azonenberg/sata-sniffer/doc/ram-performance.ods

Bank machines | LUT | LUTRAM | FF | Write Mbps | Avail Mbps | Overhead Mbps | Notes
4 | 5212 | 932 | 4469 | 12678 | 9229 | 24554
2 | 4950 | 932 | 4286 | 7413 | 3706 | 32258 | Write BW reduced due to FIFO overflows
8 | 5908 | 932 | 4825 | 11325 | 23248 | 10779
8 |  |  |  | 13025 | 17791 | 15027 | Tweaked arb strategy
 |  |  |  | 11929 | 21044 | 11991 | Tweaked arb strategy
