azonenberg/sata-sniffer/mcu-pmod/mcu-pmod.kicad_pcb

## KiCad design mcu-pmod/mcu-pmod.kicad_pcb (2022-06-13)

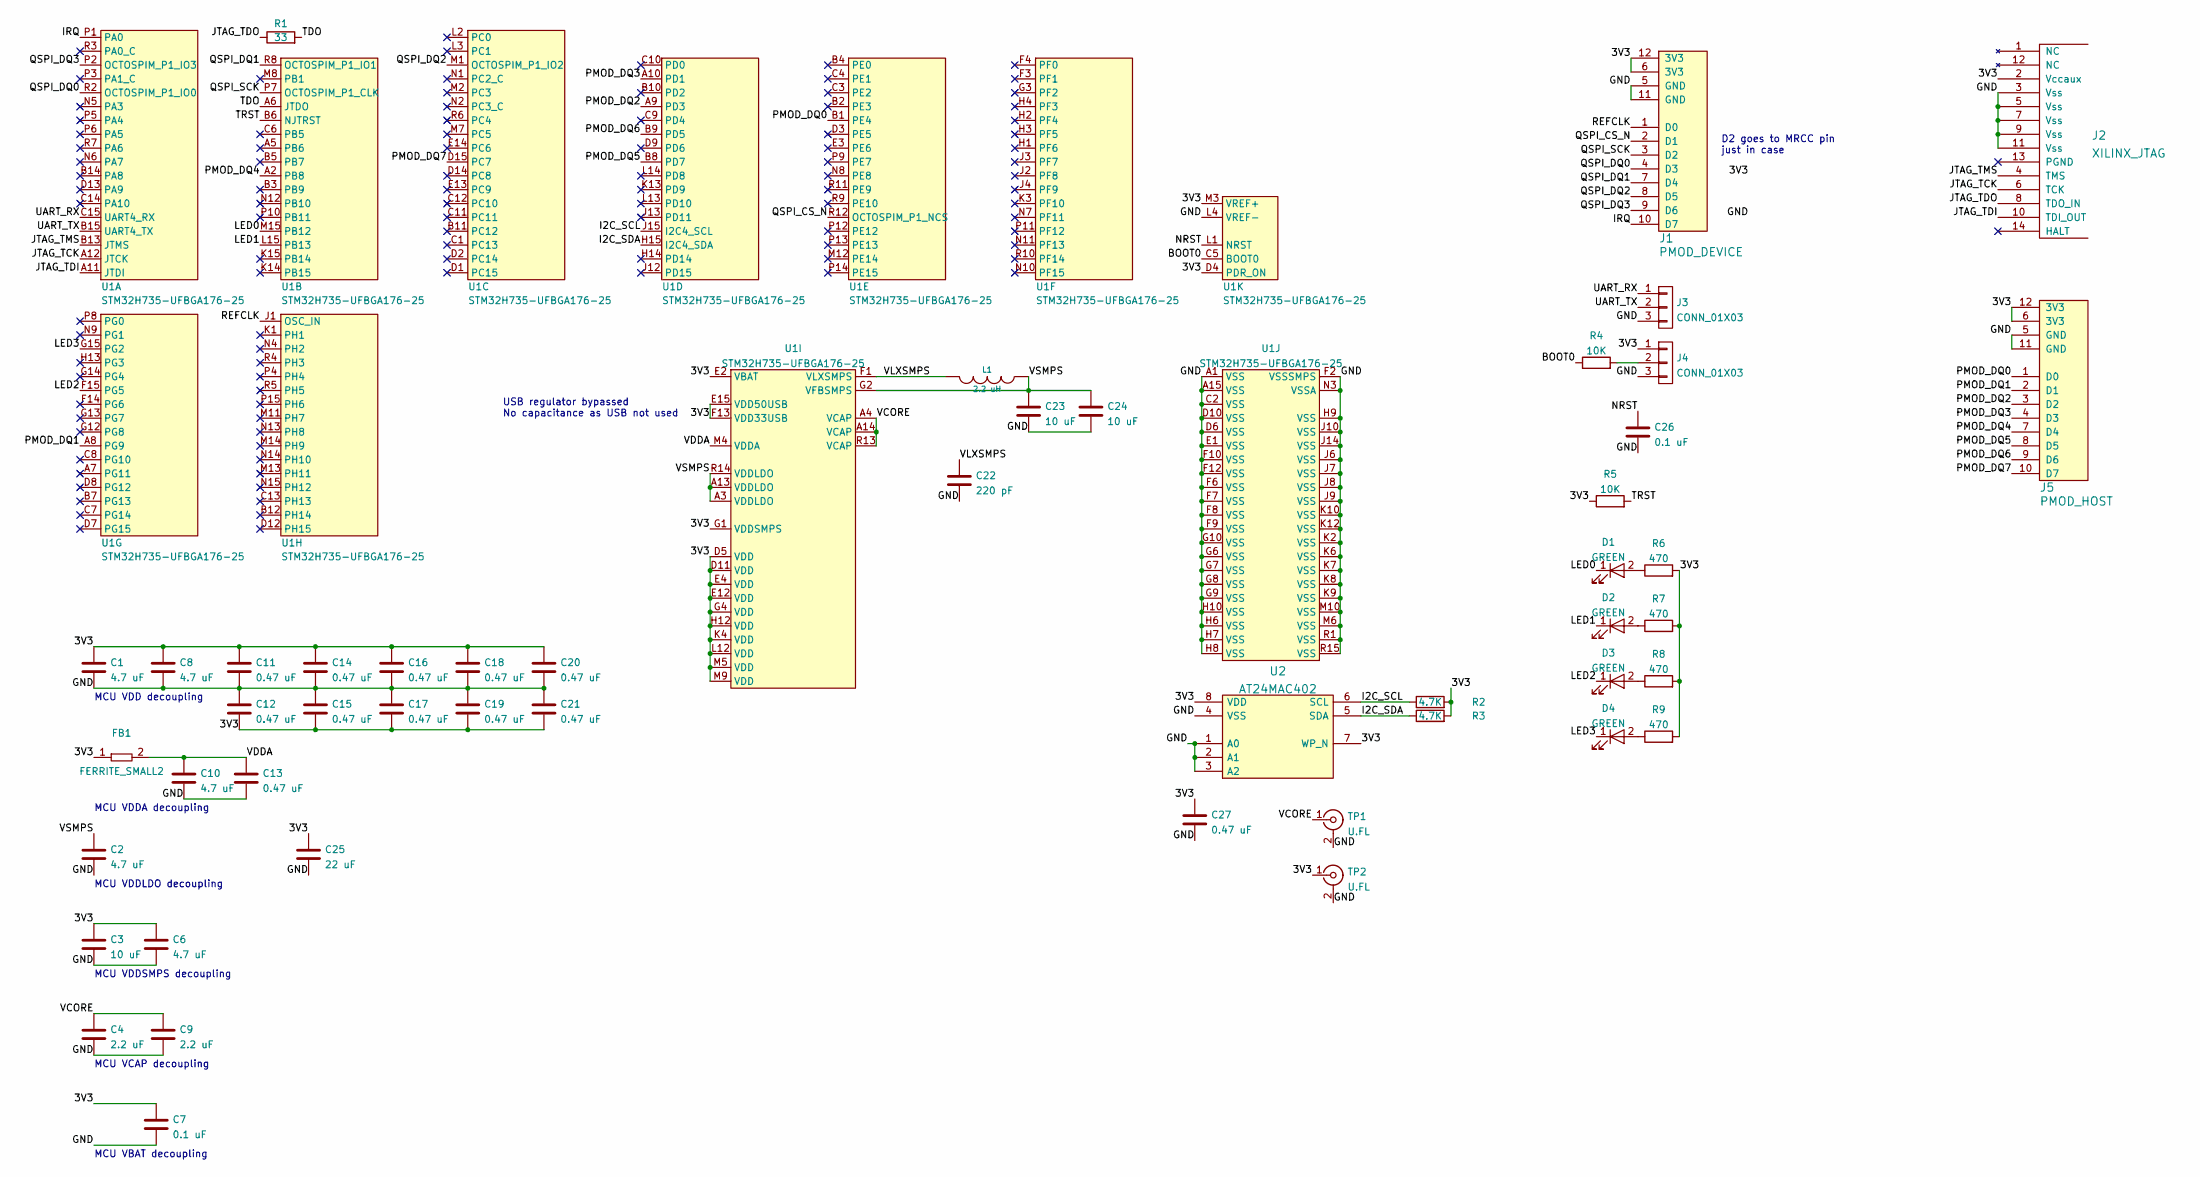
[picture p1: schematic mcu-pmod.kicad_sch, MCU PMOD]

Parts:
C1, C2, C6, C8, C10: 4.7 uF; EIA_0603_CAP_NOSILK
C3, C23, C24: 10 uF; EIA_0805_CAP_NOSILK
C4, C9: 2.2 uF; EIA_0603_CAP_NOSILK
C7, C26: 0.1 uF; EIA_0402_CAP_NOSILK
C11, C12, C13, C14, C15, C16, C17, C18, C19, C20, C21, C27: 0.47 uF; EIA_0402_CAP_NOSILK
C22: 220 pF; EIA_0402_CAP_NOSILK
C25: 22 uF; EIA_1206_CAP_NOSILK
D1, D2, D3, D4: GREEN; EIA_0805_LED
FB1: FERRITE_SMALL2; EIA_0603_INDUCTOR_NOSILK
J1: PMOD_DEVICE; CONN_HEADER_2.54MM_2x6_RA_PMOD_MODULE
J2: XILINX_JTAG; XILINX_JTAG_PTH_MOLEX_0878311420
J3, J4: CONN_01X03; CONN_HEADER_2.54MM_1x3
J5: PMOD_HOST; CONN_HEADER_2.54MM_2x6_RA_PMOD_HOST
L1: 2.2 uH; EIA_1210_CAP_NOSILK
R1: 33; EIA_0402_RES_NOSILK
R2, R3: 4.7K; EIA_0402_RES_NOSILK
R4, R5: 10K; EIA_0402_RES_NOSILK
R6, R7, R8, R9: 470; EIA_0402_RES_NOSILK
TP1, TP2: U.FL; CONN_U.FL_TE_1909763-1
U1: STM32H735-UFBGA176-25; BGA_201_10x10_DEPOP_0.65MM_OSHPARK
U2: AT24MAC402; DFN_8_0.5MM_2x3MM_TALL

Connections:
/3V3: C1.1, C3.1, C6.1, C7.1, C8.1, C11.1, C12.2, C14.1, C15.2, C16.1, C17.2, C18.1, C19.2, C20.1, C21.2, C25.1, C27.1, FB1.1, J1.6 (3V3), J1.12 (3V3), J2.2 (Vccaux), J4.1, J5.6 (3V3), J5.12 (3V3), R2.2, R3.2, R5.1, R6.2, R7.2, R8.2, R9.2, TP2.1 (In), U1.D4 (PDR_ON), U1.D5 (VDD), U1.D11 (VDD), U1.E2 (VBAT), U1.E4 (VDD), U1.E12 (VDD), U1.E15 (VDD50USB), U1.F13 (VDD33USB), U1.G1 (VDDSMPS), U1.G4 (VDD), U1.H12 (VDD), U1.K4 (VDD), U1.L12 (VDD), U1.M3 (VREF+), U1.M5 (VDD), U1.M9 (VDD), U2.7 (WP_N), U2.8 (VDD)
/BOOT0: R4.1, U1.C5 (BOOT0)
/GND: C1.2, C2.2, C3.2, C4.2, C6.2, C7.2, C8.2, C9.2, C10.2, C11.2, C12.1, C13.2, C14.2, C15.1, C16.2, C17.1, C18.2, C19.1, C20.2, C21.1, C22.2, C23.2, C24.2, C25.2, C26.2, C27.2, J1.5 (GND), J1.11 (GND), J2.3 (Vss), J2.5 (Vss), J2.7 (Vss), J2.9 (Vss), J2.11 (Vss), J3.3, J4.3, J5.5 (GND), J5.11 (GND), TP1.2 (Ext), TP2.2 (Ext), U1.A1 (VSS), U1.A15 (VSS), U1.C2 (VSS), U1.D6 (VSS), U1.D10 (VSS), U1.E1 (VSS), U1.F2 (VSSSMPS), U1.F6 (VSS), U1.F7 (VSS), U1.F8 (VSS), U1.F9 (VSS), U1.F10 (VSS), U1.F12 (VSS), U1.G6 (VSS), U1.G7 (VSS), U1.G8 (VSS), U1.G9 (VSS), U1.G10 (VSS), U1.H6 (VSS), U1.H7 (VSS), U1.H8 (VSS), U1.H9 (VSS), U1.H10 (VSS), U1.J6 (VSS), U1.J7 (VSS), U1.J8 (VSS), U1.J9 (VSS), U1.J10 (VSS), U1.J14 (VSS), U1.K2 (VSS), U1.K6 (VSS), U1.K7 (VSS), U1.K8 (VSS), U1.K9 (VSS), U1.K10 (VSS), U1.K12 (VSS), U1.L4 (VREF-), U1.M6 (VSS), U1.M10 (VSS), U1.N3 (VSSA), U1.R1 (VSS), U1.R15 (VSS), U2.1 (A0), U2.2 (A1), U2.3 (A2), U2.4 (VSS)
/I2C_SCL: R2.1, U1.J15 (I2C4_SCL), U2.6 (SCL)
/I2C_SDA: R3.1, U1.H15 (I2C4_SDA), U2.5 (SDA)
/IRQ: J1.10 (D7), U1.P1 (PA0)
/JTAG_TCK: J2.6 (TCK), U1.A12 (JTCK)
/JTAG_TDI: J2.10 (TDI_OUT), U1.A11 (JTDI)
/JTAG_TDO: J2.8 (TDO_IN), R1.1
/JTAG_TMS: J2.4 (TMS), U1.B13 (JTMS)
/LED0: D1.1 (K), U1.M15 (PB12)
/LED1: D2.1 (K), U1.L15 (PB13)
/LED2: D3.1 (K), U1.F15 (PG5)
/LED3: D4.1 (K), U1.G15 (PG2)
/NRST: C26.1, U1.L1 (NRST)
/PMOD_DQ0: J5.1 (D0), U1.B1 (PE4)
/PMOD_DQ1: J5.2 (D1), U1.A8 (PG9)
/PMOD_DQ2: J5.3 (D2), U1.A9 (PD3)
/PMOD_DQ3: J5.4 (D3), U1.A10 (PD1)
/PMOD_DQ4: J5.7 (D4), U1.A2 (PB8)
/PMOD_DQ5: J5.8 (D5), U1.B8 (PD7)
/PMOD_DQ6: J5.9 (D6), U1.B9 (PD5)
/PMOD_DQ7: J5.10 (D7), U1.D15 (PC7)
/QSPI_CS_N: J1.2 (D1), U1.R12 (OCTOSPIM_P1_NCS)
/QSPI_DQ0: J1.4 (D3), U1.R2 (OCTOSPIM_P1_IO0)
/QSPI_DQ1: J1.7 (D4), U1.R8 (OCTOSPIM_P1_IO1)
/QSPI_DQ2: J1.8 (D5), U1.M1 (OCTOSPIM_P1_IO2)
/QSPI_DQ3: J1.9 (D6), U1.P2 (OCTOSPIM_P1_IO3)
/QSPI_SCK: J1.3 (D2), U1.P7 (OCTOSPIM_P1_CLK)
/REFCLK: J1.1 (D0), U1.J1 (OSC_IN)
/TDO: R1.2, U1.A6 (JTDO)
/TRST: R5.2, U1.B6 (NJTRST)
/UART_RX: J3.1, U1.C15 (UART4_RX)
/UART_TX: J3.2, U1.B15 (UART4_TX)
/VCORE: C4.1, C9.1, TP1.1 (In), U1.A4 (VCAP), U1.A14 (VCAP), U1.R13 (VCAP)
/VDDA: C10.1, C13.1, FB1.2, U1.M4 (VDDA)
/VLXSMPS: C22.1, L1.2, U1.F1 (VLXSMPS)
/VSMPS: C2.1, C23.1, C24.1, L1.1, U1.A3 (VDDLDO), U1.A13 (VDDLDO), U1.G2 (VFBSMPS), U1.R14 (VDDLDO)
unnamed: D1.2 (A), R6.1
unnamed: D2.2 (A), R7.1
unnamed: D3.2 (A), R8.1
unnamed: D4.2 (A), R9.1
unnamed: J4.2, R4.2

Notes on the sheet:
MCU VDDA decoupling
D2 goes to MRCC pin just in case
USB regulator bypassed No capacitance as USB not used
MCU VDDSMPS decoupling
MCU VCAP decoupling
MCU VDD decoupling
MCU VDDLDO decoupling
MCU VBAT decoupling

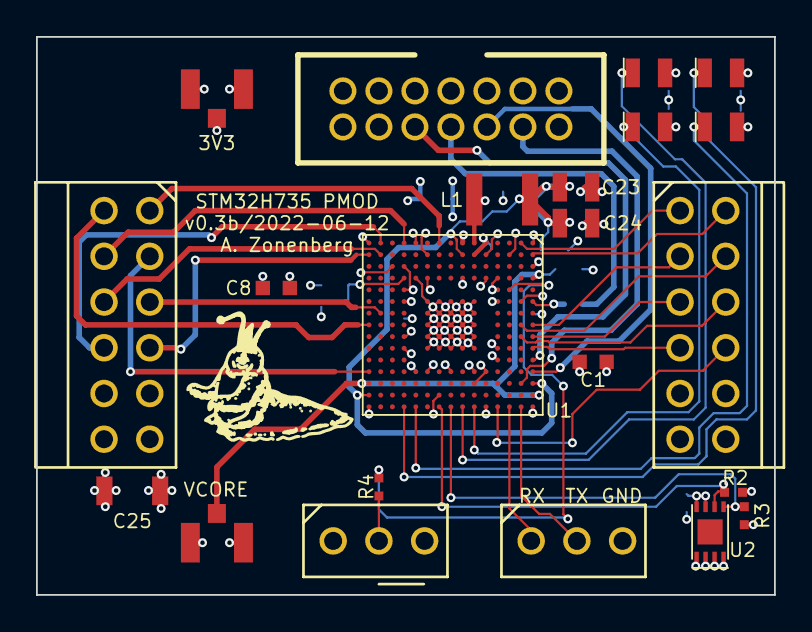
[picture p2: board mcu-pmod.kicad_pcb from above]

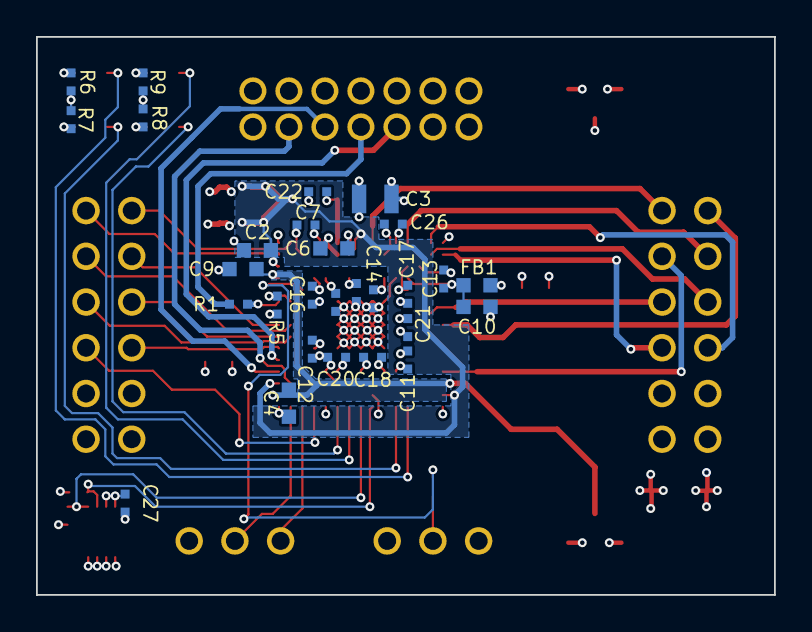
[picture p3: board mcu-pmod.kicad_pcb from below]

Board: 4 copper layers, 41.0 x 31.0 mm, 50 parts (28 on the bottom side), 43 nets.
