azonenberg/sata-sniffer/board/sniffer.kicad_pcb

## KiCad design board/sniffer.kicad_pcb (2021-12-11)

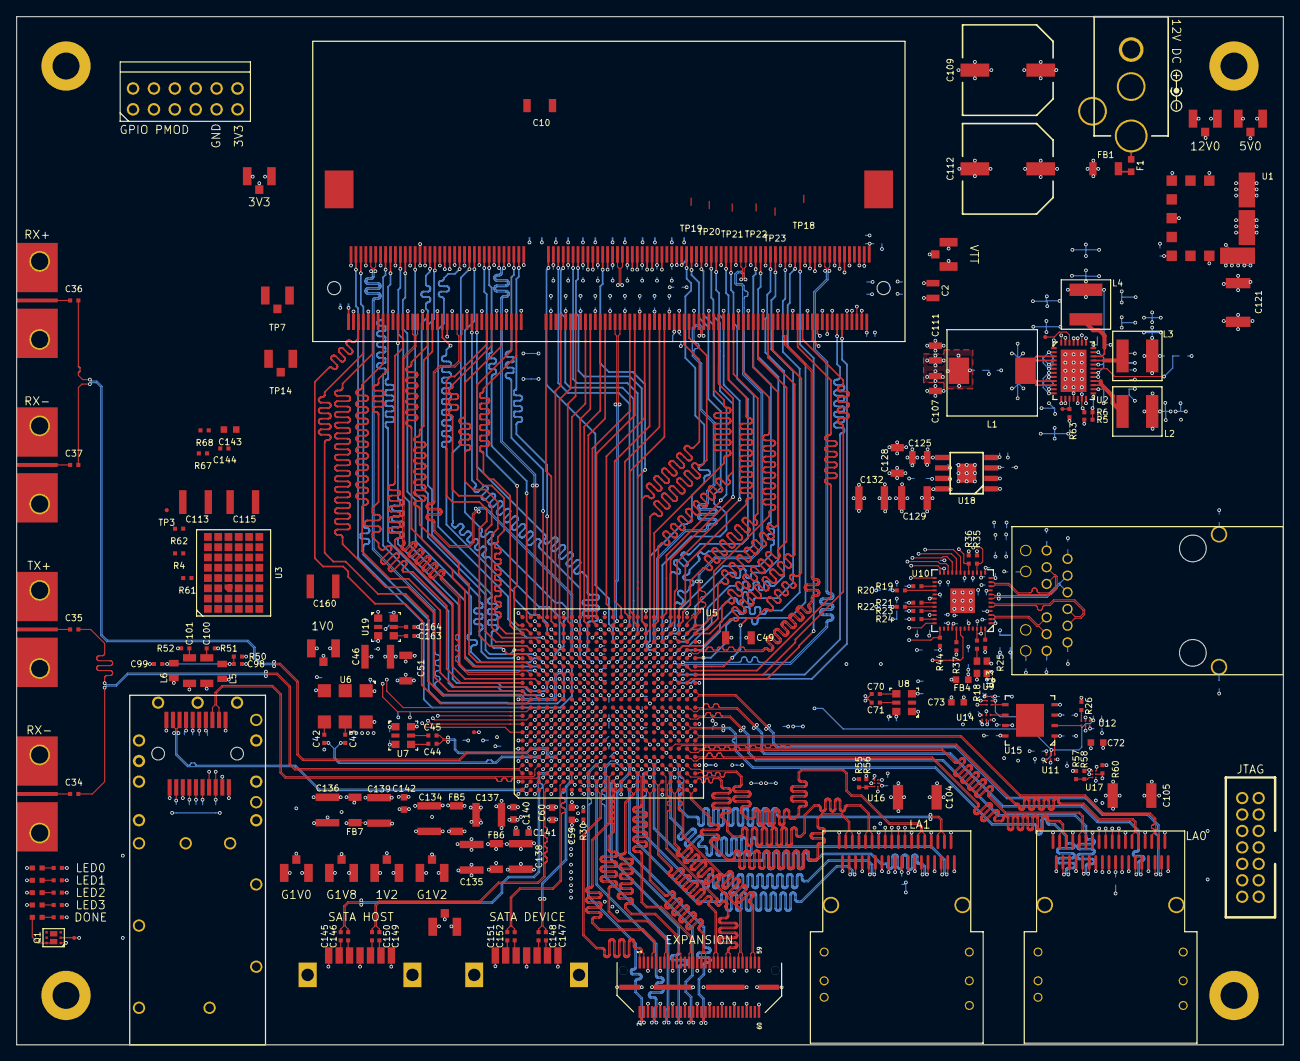
[picture p4: board sniffer.kicad_pcb from above]

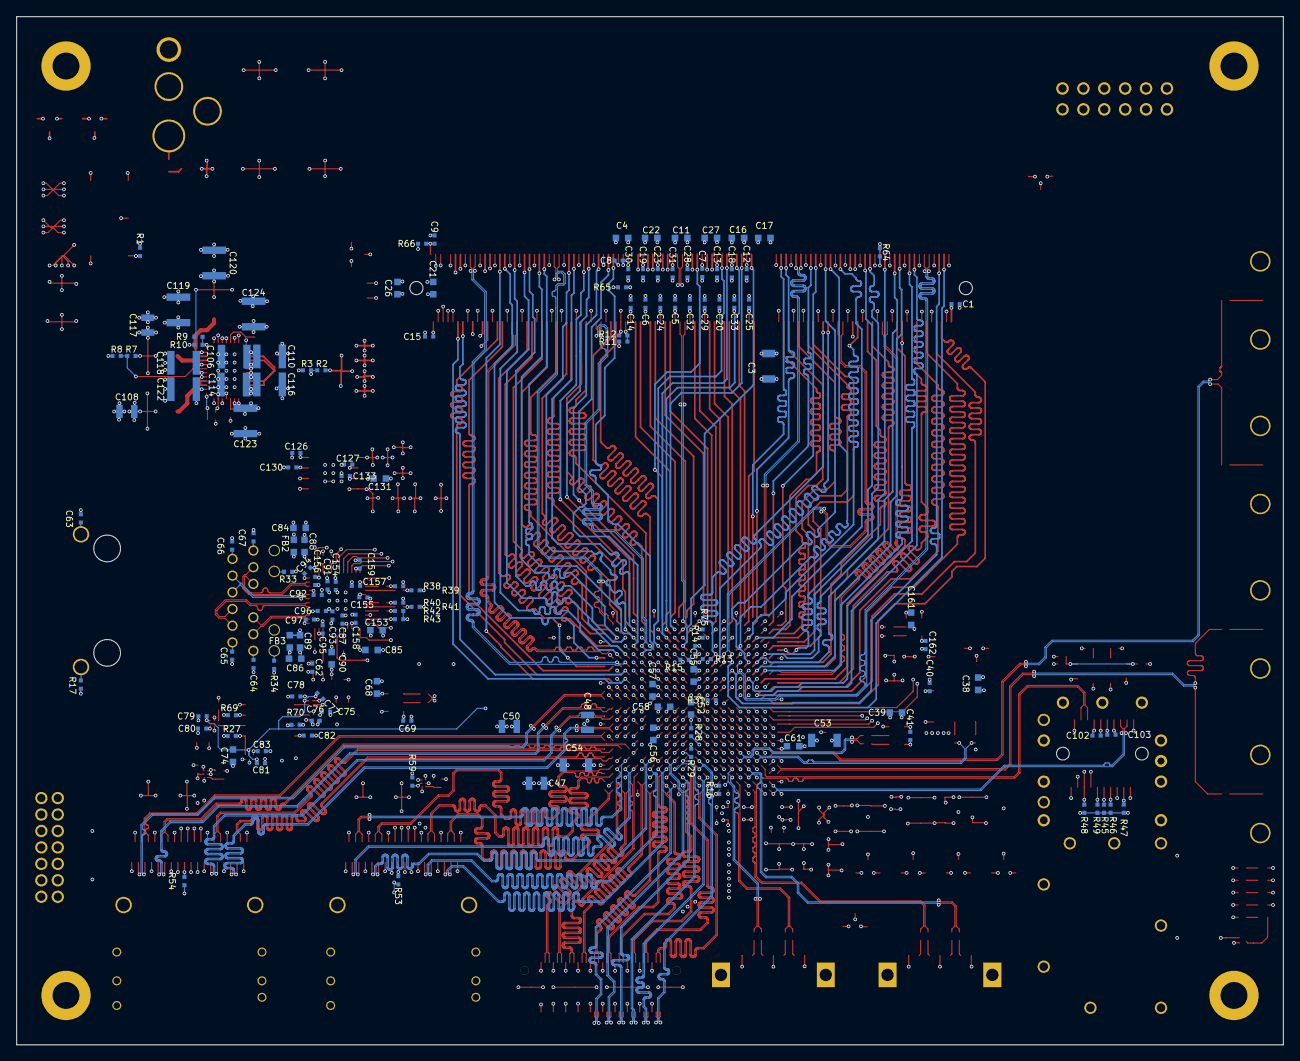
[picture p5: board sniffer.kicad_pcb from below]

Board: 8 copper layers, 154.0 x 125.0 mm, 320 parts (148 on the bottom side), 381 nets.

Parts:
C1, C5, C6, C7, C8, C9, C12, C13, C14, C15, C18, C19, C20, C23, C24, C25, C28, C29, C30, C31, C32, C33, C40, C41, C62, C69, C75, C76, C77, C78, C79, C80, C81, C82, C83, C87, C91, C92, C93, C94, C95, C96, C97, C127, C133, C144, C154, C155, C156, C157, C158, C159, C162: 0.47 uF; EIA_0402_CAP_NOSILK
C2, C117: 22 uF; EIA_0805_CAP_NOSILK
C3, C10, C49, C51, C54: 100 uF; EIA_1206_CAP_NOSILK
C4, C11, C16, C17, C22, C27, C38, C39, C52, C55, C56, C57, C58, C59, C60, C61, C68, C72, C73, C74, C84, C85, C86, C88, C89, C90, C131, C140, C141, C142, C143, C153, C161: 4.7 uF; EIA_0603_CAP_NOSILK
C21, C26: DNP; EIA_0603_CAP_NOSILK
C34, C35, C36, C37, C42, C43, C44, C45, C63, C64, C65, C66, C67, C70, C71, C98, C99, C102, C103, C126, C130, C145, C146, C147, C148, C149, C150, C151, C152, C163, C164: 0.1 uF; EIA_0402_CAP_NOSILK
C46: 330 uF; EIA_1210_CAP_NOSILK
C47, C48, C50, C107, C108, C111, C125: 47 uF; EIA_0805_CAP_NOSILK
C53, C128: 47 uF; EIA_1206_CAP_NOSILK
C100, C101: 22 uF; EIA_1206_CAP_NOSILK
C104, C105: 22 uF 25V; EIA_1812_CAP_NOSILK
C106, C110, C114, C116, C118, C119, C122, C123, C124: 10 uF; EIA_1210_CAP_NOSILK
C109, C112: 470 uF; CAP_AL_10MM_SMT
C113, C115, C129, C132: 100 uF; EIA_1210_CAP_NOSILK
C120: 22 uF; EIA_1210_CAP_NOSILK
C121: 22 uF; EIA_1812_CAP_NOSILK
C134, C135, C136, C137, C138, C139: 47 uF; EIA_1210_CAP_NOSILK
C160: DNP; EIA_1210_CAP_NOSILK
D1, D2, D3, D4, D5: GREEN; EIA_0402_LED
F1: 2A; EIA_0603_CAP_NOSILK
FB1, FB5, FB6, FB7: BLM31KN271SH1L; EIA_1206_CAP_NOSILK
FB2, FB3, FB4: MI0603J601R-10; EIA_0603_INDUCTOR_NOSILK
J1: BARREL; CONN_CUI_PJ-058BH_HIPWR_BARREL_NOSLOT
J2, J5, J6, J7: 32K243-40ML5; CONN_SMA_EDGE_ROSENBERGER_32K243_40ML5
J3: BEL_FUSE_0826-1G1T-23-F; CONN_BELFUSE_0826_1G1T_23_F
J4: XILINX_JTAG; XILINX_JTAG_PTH_MOLEX_0878311420
J8, J9: CONN_SFF8087; CONN_SFF8087_MOLEX_75783-0140
J10: CONN_SFP_HOST; CONN_SFP+_AMPHENOL_UE76_A10_2000T
J11: SFP_CAGE; CONN_SFP_CAGE_TE_2007194-1
J12: PMOD_HOST; CONN_HEADER_2.54MM_2x6_RA_PMOD_HOST
J13: CONN_SATA_DEVICE; CONN_SATA_MOLEX_0674901220
J14: CONN_SATA_HOST; CONN_SATA_MOLEX_0674901220
J15: CONN_LVDS_EXPANSION_HOST; CONN_SAMTEC_QTH-030-01-L-D-A
L1: NS10145T2R2NNA; INDUCTOR_YUDEN_LSRN_10145
L2, L3, L4: NRS5030T2R2NMGJ; INDUCTOR_YUDEN_NRS5030
L5, L6: 4.7 uH; EIA_0805_INDUCTOR_NOSILK
M1, M2, M3, M4: SCREW_HOLE; MECHANICAL_CLEARANCEHOLE_4_40
Q1: SSM6N58NU; DFN_6_0.65MM_2x2MM_GDS
R1: 1.33K; EIA_0402_RES_NOSILK
R2: 442K; EIA_0402_RES_NOSILK
R3, R8: 649K; EIA_0402_RES_NOSILK
R4: 1.78K; EIA_0402_RES_NOSILK
R5: 232K; EIA_0402_RES_NOSILK
R6: 464K; EIA_0402_RES_NOSILK
R7: 806K; EIA_0402_RES_NOSILK
R9: 1.02M; EIA_0402_RES_NOSILK
R10: 324K; EIA_0402_RES_NOSILK
R11, R12: DNP; EIA_0402_RES_NOSILK
R13, R15, R18, R19, R20, R21, R22, R23, R24, R26, R30, R31: 33; EIA_0402_RES_NOSILK
R14, R35, R36, R44, R67, R68: 1K; EIA_0402_RES_NOSILK
R16, R65, R75: 100; EIA_0402_RES_NOSILK
R17, R55, R57: 1M; EIA_0402_RES_NOSILK
R25: 12.1K 1%; EIA_0402_RES_NOSILK
R27, R37, R38, R39, R40, R41, R42, R43, R49, R59, R60, R62, R63, R69, R70: 10K; EIA_0402_RES_NOSILK
R28, R29, R45, R46, R47, R48, R64: 4.7K; EIA_0402_RES_NOSILK
R32, R33, R34, R71, R72, R73, R74: 470; EIA_0402_RES_NOSILK
R50: 0.1; EIA_0402_RES_NOSILK
R51, R52: 0.5; EIA_0402_RES_NOSILK
R53, R54: 100K; EIA_0402_RES_NOSILK
R56, R58: 93.1K; EIA_0402_RES_NOSILK
R61, R66: 0; EIA_0402_RES_NOSILK
TP1, TP2, TP3, TP4, TP5: TESTPOINT; TESTPOINT_SMT_0.5MM
TP6, TP7, TP8, TP9, TP10, TP11, TP12, TP13, TP14, TP15, TP16, TP17: U.FL; CONN_U.FL_TE_1909763-1
TP18, TP19, TP20, TP21, TP22, TP23: TESTTRACE; TESTPOINT_BARETRACE_150UM
U1: OKL-T_3-W12P-C; MODULE_MURATA_OKL-T3-W12
U2: LTC3374-QFN; QFN_38_0.5MM_5x7MM
U3: MYTNA1R84RELA2RA; MODULE_MURATA_MYTNA1R84RELA2RA
U4: DDR3_SODIMM; CONN_SODIMM_DDR3_TE_2013289-1
U5: XC7K70T-2FBG484; BGA_484_22x22_FULLARRAY_1MM
U6: ECX2-LMV-7CN-156.250-TR; OSCILLATOR_LVDS_7.0x5.0
U7, U19: SIT9121AI-2BF-XXS200.000000G; OSCILLATOR_LVDS_3.2x2.5
U8: ECX2-LMV-3CN-125.000-TR; OSCILLATOR_LVDS_3.2x2.5
U9: ECS-2016MVQ-250-CN; OSCILLATOR_2.0x1.6
U10: KSZ9031RN; QFN_48_0.5MM_7x7MM
U11, U12, U13, U14: 74AVCH1T45; DFN_6_0.5MM_1.45x1.00MM
U15: W25Q128JV; DFN_8_1.27MM_6x5MM
U16, U17: FPF2498; BGA_6_1.3x1.0_0.4MM
U18: LP2996A; SOIC_8_3.9MM_EPAD

Connections:
/1V0: C46.1, C51.1, C55.1, C57.1, C113.1, C115.1, C136.1, C160.1, FB7.1, R61.2, TP13.1, U3.G4, U3.G5, U3.H4, U3.H5, U3.H6, U5.J9, U5.J11, U5.J13, U5.J15, U5.K8, U5.K14, U5.L9, U5.L13, U5.L15, U5.M8, U5.M14, U5.N9, U5.N13, U5.N15, U5.P14, U5.R13, U5.R15
/1V2: C86.1, C108.1, C134.1, C153.1, C154.1, C155.1, C156.1, C157.1, C158.1, C159.1, FB3.1, FB4.1, FB5.1, L2.1, R5.1, TP12.1, U10.14, U10.18, U10.23, U10.26, U10.30, U10.39
/1V8: C47.1, C48.1, C50.1, C52.1, C54.1, C56.1, C58.1, C62.1, C73.1, C76.1, C85.1, C87.1, C91.1, C117.1, C135.1, FB6.1, J4.2, L3.1, R7.1, R28.2, R29.2, R37.1, R38.1, R39.1, R40.1, R44.1, TP11.1, U5.AA7, U5.AB4, U5.H7, U5.J7, U5.K10, U5.K12, U5.M4, U5.M10, U5.N1, U5.N7, U5.P7, U5.P8, U5.P10, U5.P12, U5.R5, U5.R9, U5.R11, U5.T2, U5.T12, U5.U9, U5.V6, U5.W3, U5.W13, U5.Y10, U9.1, U9.4, U10.16, U10.34, U10.40, U14.1, U14.5
/1V35: C3.1, C4.1, C5.1, C6.1, C7.1, C10.1, C11.1, C12.1, C13.1, C14.1, C16.1, C17.1, C18.1, C19.1, C20.1, C22.1, C23.1, C24.1, C25.1, C27.1, C28.1, C29.1, C30.1, C31.1, C32.1, C33.1, C49.1, C74.1, C77.1, C79.1, C81.1, C107.1, C111.1, C128.1, C131.1, C133.1, L1.1, R2.1, R11.1, R14.1, R65.2, R67.1, TP14.1, U4.75, U4.76, U4.81, U4.82, U4.87, U4.88, U4.93, U4.94, U4.99, U4.100, U4.105, U4.106, U4.111, U4.112, U4.117, U4.118, U4.123, U4.124, U5.A17, U5.AA17, U5.AB14, U5.B14, U5.C21, U5.D18, U5.E15, U5.F22, U5.G19, U5.H16, U5.K20, U5.L17, U5.N21, U5.P18, U5.T22, U5.U19, U5.V16, U5.Y20, U11.1, U11.5, U12.1, U13.1, U13.5, U18.7
/3.3V I/O/ETH_LED1_P: R33.1, U5.H9
/3.3V I/O/ETH_LED2_P: R34.1, U5.H8
/3.3V I/O/LA0_12V0: C105.1, J9.A11, J9.B8, J9.B9, J9.B10, J9.B11, U17.B1
/3.3V I/O/LA0_12V0_EN: R60.2, U5.F8, U17.B2
/3.3V I/O/LA0_12V0_FAULT: U5.G8, U17.C2
/3.3V I/O/LA0_PRESENCE_DETECT: J9.A10, R54.1, U5.F9
/3.3V I/O/LA0_UART_RX: J9.A8, U5.E9
/3.3V I/O/LA0_UART_TX: J9.A9, U5.E8
/3.3V I/O/LA1_12V0: C104.1, J8.A11, J8.B8, J8.B9, J8.B10, J8.B11, U16.B1
/3.3V I/O/LA1_12V0_EN: R59.2, U5.C9, U16.B2
/3.3V I/O/LA1_12V0_FAULT: U5.D9, U16.C2
/3.3V I/O/LA1_PRESENCE_DETECT: J8.A10, R53.1, U5.C8
/3.3V I/O/LA1_UART_RX: J8.A8, U5.B8
/3.3V I/O/LA1_UART_TX: J8.A9, U5.C10
/3.3V I/O/LED0: R71.2, U5.A8
/3.3V I/O/LED1: R72.2, U5.A9
/3.3V I/O/LED2: R73.2, U5.B10
/3.3V I/O/LED3: R74.2, U5.A10
/3.3V I/O/PMOD_DQ0: J12.1, U5.H10
/3.3V I/O/PMOD_DQ1: J12.2, U5.F10
/3.3V I/O/PMOD_DQ2: J12.3, U5.G11
/3.3V I/O/PMOD_DQ3: J12.4, U5.A11
/3.3V I/O/PMOD_DQ4: J12.7, U5.G10
/3.3V I/O/PMOD_DQ5: J12.8, U5.D10
/3.3V I/O/PMOD_DQ6: J12.9, U5.B11
/3.3V I/O/PMOD_DQ7: J12.10, U5.G12
/3.3V I/O/SFP_MOD_ABS: J10.6, R49.2, U5.E12
/3.3V I/O/SFP_RS0: J10.7, U5.F11
/3.3V I/O/SFP_RS1: J10.9, U5.D11
/3.3V I/O/SFP_RX_LOS: J10.8, R48.2, U5.E11
/3.3V I/O/SFP_TX_DISABLE: J10.3, U5.E13
/3.3V I/O/SFP_TX_FAULT: J10.2, R47.2, U5.F13
/3V3: C38.1, C39.1, C40.1, C41.1, C53.1, C68.1, C69.1, C72.1, C75.1, C78.1, C80.1, C82.1, C83.1, C84.1, C120.1, C127.1, C161.1, C162.1, FB2.1, J12.6, J12.12, L4.1, R9.1, R27.2, R32.1, R45.1, R46.1, R47.1, R48.1, R49.1, R50.2, R53.2, R54.2, R62.2, R63.1, R69.2, R70.1, TP10.1, U4.199, U5.C11, U5.D8, U5.F12, U5.G9, U6.1, U6.6, U7.1, U7.6, U8.1, U8.6, U11.6, U12.6, U13.6, U14.6, U15.8, U18.2, U18.6, U19.1, U19.6
/5V0: C106.1, C110.1, C114.1, C116.1, C118.1, C119.1, C121.1, C122.1, C123.1, C124.1, J15.59, J15.60, TP9.1, U1.4, U1.5, U2.2, U2.5, U2.6, U2.7, U2.8, U2.11, U2.12, U2.17, U2.21, U2.24, U2.25, U2.27, U2.30, U2.32, U2.34, U2.35
/12V0: C109.1, C112.1, FB1.2, R55.1, R57.1, TP8.1, U1.1, U1.2, U1.9, U3.A1, U3.A2, U3.A3, U3.B1, U3.B2, U3.B3, U16.A2, U17.A2
/Boot flash/FLASH_CS: R15.1, U11.3
/Boot flash/FLASH_CS_SHIFT: R27.1, U11.4, U15.1
/Boot flash/FLASH_SCK: R31.2, U14.3
/Boot flash/FLASH_SCK_SHIFT: U14.4, U15.6
/Boot flash/FLASH_SI: R13.1, U13.3
/Boot flash/FLASH_SI_SHIFT: U13.4, U15.5
/Boot flash/FLASH_SO: R26.2, U5.H19
/Boot flash/FLASH_SO_SHIFT: U12.4, U15.2
/DDR/CLK_200_AC_N: C164.1, R75.2, U5.L20
/DDR/CLK_200_AC_P: C163.1, R75.1, U5.L19
/DDR/CLK_200_N: C164.2, U19.5
/DDR/CLK_200_P: C163.2, U19.4
/DDR/RAM_A0: U4.98, U5.M17
/DDR/RAM_A1: U4.97, U5.J22
/DDR/RAM_A2: U4.96, U5.R22
/DDR/RAM_A3: U4.95, U5.J21
/DDR/RAM_A4: U4.92, U5.J20
/DDR/RAM_A5: U4.91, U5.H22
/DDR/RAM_A6: U4.90, U5.H20
/DDR/RAM_A7: U4.86, U5.R18
/DDR/RAM_A8: U4.89, U5.G22
/DDR/RAM_A9: U4.85, U5.G21
/DDR/RAM_A10: U4.107, U5.K21
/DDR/RAM_A11: U4.84, U5.P19
/DDR/RAM_A12: U4.83, U5.F21
/DDR/RAM_A13: U4.119, U5.P22
/DDR/RAM_A14: U4.80, U5.P20
/DDR/RAM_A15: U4.78, U5.P21
/DDR/RAM_BA0: U4.109, U5.K22
/DDR/RAM_BA1: U4.108, U5.N17
/DDR/RAM_BA2: U4.79, U5.E22
/DDR/RAM_CAS_N: U4.115, U5.N22
/DDR/RAM_CK0_N: U4.103, U5.M21
/DDR/RAM_CK0_P: U4.101, U5.N20
/DDR/RAM_CK1_N: U4.104, U5.L21
/DDR/RAM_CK1_P: U4.102, U5.M20
/DDR/RAM_CKE0: U4.73, U5.E21
/DDR/RAM_CKE1: U4.74, U5.M18
/DDR/RAM_CS0_N: U4.114, U5.P16
/DDR/RAM_CS1_N: U4.121, U5.R21
/DDR/RAM_DM0: U4.11, U5.A13
/DDR/RAM_DM1: U4.28, U5.C17
/DDR/RAM_DM2: U4.46, U5.D19
/DDR/RAM_DM3: U4.63, U5.C19
/DDR/RAM_DM4: U4.136, U5.V22
/DDR/RAM_DM5: U4.153, U5.AB21
/DDR/RAM_DM6: U4.170, U5.Y17
/DDR/RAM_DM7: U4.187, U5.Y14
/DDR/RAM_DQ0_0: U4.5, U5.B12
/DDR/RAM_DQ0_1: U4.7, U5.C12
/DDR/RAM_DQ0_2: U4.15, U5.B13
/DDR/RAM_DQ0_3: U4.17, U5.A14
/DDR/RAM_DQ0_4: U4.4, U5.G16
/DDR/RAM_DQ0_5: U4.6, U5.G15
/DDR/RAM_DQ0_6: U4.16, U5.C13
/DDR/RAM_DQ0_7: U4.18, U5.E14
/DDR/RAM_DQ1_0: U4.21, U5.C15
/DDR/RAM_DQ1_1: U4.23, U5.C14
/DDR/RAM_DQ1_2: U4.33, U5.A16
/DDR/RAM_DQ1_3: U4.35, U5.B16
/DDR/RAM_DQ1_4: U4.22, U5.D15
/DDR/RAM_DQ1_5: U4.24, U5.D16
/DDR/RAM_DQ1_6: U4.34, U5.A18
/DDR/RAM_DQ1_7: U4.36, U5.B17
/DDR/RAM_DQ2_0: U4.39, U5.E19
/DDR/RAM_DQ2_1: U4.41, U5.E18
/DDR/RAM_DQ2_2: U4.51, U5.J16
/DDR/RAM_DQ2_3: U4.53, U5.J17
/DDR/RAM_DQ2_4: U4.40, U5.D17
/DDR/RAM_DQ2_5: U4.42, U5.E17
/DDR/RAM_DQ2_6: U4.50, U5.F18
/DDR/RAM_DQ2_7: U4.52, U5.E16
/DDR/RAM_DQ3_0: U4.57, U5.B18
/DDR/RAM_DQ3_1: U4.59, U5.A19
/DDR/RAM_DQ3_2: U4.67, U5.A20
/DDR/RAM_DQ3_3: U4.69, U5.B20
/DDR/RAM_DQ3_4: U4.56, U5.A21
/DDR/RAM_DQ3_5: U4.58, U5.B21
/DDR/RAM_DQ3_6: U4.68, U5.D21
/DDR/RAM_DQ3_7: U4.70, U5.D22
/DDR/RAM_DQ4_0: U4.129, U5.T21
/DDR/RAM_DQ4_1: U4.131, U5.T20
/DDR/RAM_DQ4_2: U4.141, U5.U22
/DDR/RAM_DQ4_3: U4.143, U5.U21
/DDR/RAM_DQ4_4: U4.130, U5.U17
/DDR/RAM_DQ4_5: U4.132, U5.V18
/DDR/RAM_DQ4_6: U4.140, U5.W22
/DDR/RAM_DQ4_7: U4.142, U5.W21
/DDR/RAM_DQ5_0: U4.147, U5.Y22
/DDR/RAM_DQ5_1: U4.149, U5.Y21
/DDR/RAM_DQ5_2: U4.157, U5.AA20
/DDR/RAM_DQ5_3: U4.159, U5.AB20
/DDR/RAM_DQ5_4: U4.146, U5.V20
/DDR/RAM_DQ5_5: U4.148, U5.W20
/DDR/RAM_DQ5_6: U4.158, U5.V19
/DDR/RAM_DQ5_7: U4.160, U5.AA19
/DDR/RAM_DQ6_0: U4.163, U5.Y18
/DDR/RAM_DQ6_1: U4.165, U5.AB16
/DDR/RAM_DQ6_2: U4.175, U5.AA16
/DDR/RAM_DQ6_3: U4.177, U5.AB15
/DDR/RAM_DQ6_4: U4.164, U5.Y19
/DDR/RAM_DQ6_5: U4.166, U5.W17
/DDR/RAM_DQ6_6: U4.174, U5.AB17
/DDR/RAM_DQ6_7: U4.176, U5.AA14
/DDR/RAM_DQ7_0: U4.181, U5.V15
/DDR/RAM_DQ7_1: U4.183, U5.T15
/DDR/RAM_DQ7_2: U4.191, U5.W15
/DDR/RAM_DQ7_3: U4.193, U5.W14
/DDR/RAM_DQ7_4: U4.180, U5.R16
/DDR/RAM_DQ7_5: U4.182, U5.T16
/DDR/RAM_DQ7_6: U4.192, U5.U16
/DDR/RAM_DQ7_7: U4.194, U5.U15
/DDR/RAM_DQS0_N: U4.10, U5.F16
/DDR/RAM_DQS0_P: U4.12, U5.F15
/DDR/RAM_DQS1_N: U4.27, U5.A15
/DDR/RAM_DQS1_P: U4.29, U5.B15
/DDR/RAM_DQS2_N: U4.45, U5.G17
/DDR/RAM_DQS2_P: U4.47, U5.H17
/DDR/RAM_DQS3_N: U4.62, U5.B22
/DDR/RAM_DQS3_P: U4.64, U5.C22
/DDR/RAM_DQS4_N: U4.135, U5.U18
/DDR/RAM_DQS4_P: U4.137, U5.T18
/DDR/RAM_DQS5_N: U4.152, U5.AB22
/DDR/RAM_DQS5_P: U4.154, U5.AA21
/DDR/RAM_DQS6_N: U4.169, U5.AB18
/DDR/RAM_DQS6_P: U4.171, U5.AA18
/DDR/RAM_DQS7_N: U4.186, U5.Y16
/DDR/RAM_DQS7_P: U4.188, U5.W16
/DDR/RAM_ODT0: U4.116, U5.P17
/DDR/RAM_ODT1: U4.120, U5.R17
/DDR/RAM_RAS_N: U4.110, U5.N18
/DDR/RAM_RESET_N: R64.1, U4.30, U5.N19
/DDR/RAM_TEST: R11.2, R12.2, U4.125
/DDR/RAM_WE_N: U4.113, U5.M22
/DDR/TP_VREF: C143.1, C144.1, R67.2, R68.1, TP18.1, TP19.1, TP20.1
/Expansion connector/LA1_DQ0_N: J8.B3, U5.AB1
/Expansion connector/LA1_DQ0_P: J8.B2, U5.AA1
/Expansion connector/LA1_DQ1_N: J8.B6, U5.AA3
/Expansion connector/LA1_DQ1_P: J8.B5, U5.AB2
/Expansion connector/LA1_DQ2_N: J8.B14, U5.AA4
/Expansion connector/LA1_DQ2_P: J8.B13, U5.AB3
/Expansion connector/LA1_DQ3_N: J8.B17, U5.Y4
/Expansion connector/LA1_DQ3_P: J8.B16, U5.W5
/Expansion connector/LA1_DQ4_N: J8.A3, U5.R4
/Expansion connector/LA1_DQ4_P: J8.A2, U5.P4
/Expansion connector/LA1_DQ5_N: J8.A6, U5.U3
/Expansion connector/LA1_DQ5_P: J8.A5, U5.T4
/Expansion connector/LA1_DQ6_N: J8.A14, U5.U5
/Expansion connector/LA1_DQ6_P: J8.A13, U5.T5
/Expansion connector/LA1_DQ7_N: J8.A17, U5.W4
/Expansion connector/LA1_DQ7_P: J8.A16, U5.V4
/Expansion connector/LVDS0_N: J15.3, U5.L1
/Expansion connector/LVDS0_P: J15.1, U5.K1
/Expansion connector/LVDS1_N: J15.9, U5.M3
/Expansion connector/LVDS1_P: J15.7, U5.L3
/Expansion connector/LVDS2_N: J15.15, U5.M2
/Expansion connector/LVDS2_P: J15.13, U5.M1
/Expansion connector/LVDS3_N: J15.21, U5.R1
/Expansion connector/LVDS3_P: J15.19, U5.P1
/Expansion connector/LVDS4_N: J15.27, U5.T3
/Expansion connector/LVDS4_P: J15.25, U5.R3
/Expansion connector/LVDS5_N: J15.33, U5.U1
/Expansion connector/LVDS5_P: J15.31, U5.T1
/Expansion connector/LVDS6_N: J15.39, U5.V2
/Expansion connector/LVDS6_P: J15.37, U5.U2
/Expansion connector/LVDS7_N: J15.45, U5.W2
/Expansion connector/LVDS7_P: J15.43, U5.V3
/Expansion connector/LVDS8_N: J15.51, U5.Y1
/Expansion connector/LVDS8_P: J15.49, U5.W1
/Expansion connector/LVDS9_N: J15.57, U5.Y3
/Expansion connector/LVDS9_P: J15.55, U5.Y2
/Expansion connector/LVDS10_N: J15.4, U5.L4
/Expansion connector/LVDS10_P: J15.2, U5.L5
/Expansion connector/LVDS11_N: J15.10, U5.K2
/Expansion connector/LVDS11_P: J15.8, U5.K3
/Expansion connector/LVDS12_N: J15.16, U5.N4
/Expansion connector/LVDS12_P: J15.14, U5.M5
/Expansion connector/LVDS13_N: J15.22, U5.N2
/Expansion connector/LVDS13_P: J15.20, U5.N3
/Expansion connector/LVDS14_N: J15.28, U5.P5
/Expansion connector/LVDS14_P: J15.26, U5.N5
/Expansion connector/LVDS15_N: J15.34, U5.R2
/Expansion connector/LVDS15_P: J15.32, U5.P2
/FPGA power/GTX_1V0: C61.1, C139.1, C142.1, FB7.2, TP17.1, U5.A6, U5.C6, U5.E6, U5.G6
/FPGA power/GTX_1V8: C59.1, C138.1, C141.1, FB6.2, TP16.1, U5.J4
/FPGA support/FPGA_DONE: Q1.G1, TP1.1, U5.P6
/FPGA support/FPGA_INIT_B: R28.1, TP2.1, U5.L7
/FPGA support/FPGA_RST_N: R29.1, U5.M6
/FPGA support/JTAG_TCK: J4.6, U5.K7
/FPGA support/JTAG_TDI: J4.10, U5.K6
/FPGA support/JTAG_TDO: J4.8, R30.2
/FPGA support/JTAG_TMS: J4.4, U5.L6
/GND: C1.2, C2.2, C3.2, C4.2, C5.2, C6.2, C7.2, C8.2, C9.2, C10.2, C11.2, C12.2, C13.2, C14.2, C15.2, C16.2, C17.2, C18.2, C19.2, C20.2, C21.2, C22.2, C23.2, C24.2, C25.2, C26.2, C27.2, C28.2, C29.2, C30.2, C31.2, C32.2, C33.2, C38.2, C39.2, C40.2, C41.2, C46.2, C47.2, C48.2, C49.2, C50.2, C51.2, C52.2, C53.2, C54.2, C55.2, C56.2, C57.2, C58.2, C59.2, C60.2, C61.2, C62.2, C63.1, C64.1, C65.1, C66.1, C67.1, C68.2, C69.2, C72.2, C73.2, C74.2, C75.2, C76.2, C77.2, C78.2, C79.2, C80.2, C81.2, C82.2, C83.2, C84.2, C85.2, C86.2, C87.2, C88.2, C89.2, C90.2, C91.2, C92.2, C93.2, C94.2, C95.2, C96.2, C97.2, C98.2, C99.2, C102.2, C103.2, C104.2, C105.2, C106.2, C107.2, C108.2, C109.2, C110.2, C111.2, C112.2, C113.2, C114.2, C115.2, C116.2, C117.2, C118.2, C119.2, C120.2, C121.2, C122.2, C123.2, C124.2, C125.2, C126.2, C127.2, C128.2, C129.2, C130.2, C131.2, C132.2, C133.2, C134.2, C135.2, C136.2, C137.2, C138.2, C139.2, C140.2, C141.2, C142.2, C143.2, C144.2, C153.2, C154.2, C155.2, C156.2, C157.2, C158.2, C159.2, C160.2, C161.2, C162.2, D2.1, D3.1, D4.1, D5.1, J1.2, J2.2, J3.13, J3.15, J4.3, J4.5, J4.7, J4.9, J4.11, J5.2, J6.2, J7.2, J8.A1, J8.A4, J8.A7, J8.A12, J8.A15, J8.A18, J8.B1, J8.B4, J8.B7, J8.B12, J8.B15, J8.B18, J8.SHLD, J9.A1, J9.A4, J9.A7, J9.A12, J9.A15, J9.A18, J9.B1, J9.B4, J9.B7, J9.B12, J9.B15, J9.B18, J9.SHLD, J10.1, J10.10, J10.11, J10.14, J10.17, J10.20, J11.1, J12.5, J12.11, J13.1, J13.4, J13.7, J14.1, J14.4, J14.7, J15.5, J15.6, J15.11, J15.12, J15.17, J15.18, J15.23, J15.24, J15.29, J15.30, J15.35, J15.36, J15.41, J15.42, J15.47, J15.48, J15.53, J15.54, J15.GND, Q1.S1, R1.1, R3.2, R6.2, R8.2, R10.2, R12.1, R17.1, R25.1, R35.1, R36.1, R41.1, R42.1, R43.1, R51.1, R52.1, R56.2, R58.2, R59.1, R60.1, R64.2, R68.2, TP6.2, TP7.2, TP8.2, TP9.2, TP10.2, TP11.2, TP12.2, TP13.2, TP14.2, TP15.2, TP16.2, TP17.2, TP21.1, TP22.1, TP23.1, U1.3, U1.7, U2.13, U2.14, U2.16, U2.18, U2.37, U2.PAD, U3.A4, U3.A5, U3.A6, U3.B4, U3.B5, U3.B6, U3.C2, U3.C3, U3.C4, U3.C5, U3.D2, U3.D3, U3.D4, U3.D5, U3.E2, U3.E3, U3.E4, U3.E5, U3.F2, U3.F3, U3.F4, U3.F5, U3.G1, U3.G2, U3.G3, U3.H1, U3.H2, U3.H3, U4.2, U4.3, U4.8, U4.9, U4.13, U4.14, U4.19, U4.20, U4.25, U4.26, U4.31, U4.32, U4.37, U4.38, U4.43, U4.44, U4.48, U4.49, U4.54, U4.55, U4.60, U4.61, U4.65, U4.66, U4.71, U4.72, U4.127, U4.128, U4.133, U4.134, U4.138, U4.139, U4.144, U4.145, U4.150, U4.151, U4.155, U4.156, U4.161, U4.162, U4.167, U4.168, U4.172, U4.173, U4.178, U4.179, U4.184, U4.185, U4.189, U4.190, U4.195, U4.196, U4.197, U4.201, U5.A1, U5.A5, U5.A7, U5.A12, U5.A22, U5.AA2, U5.AA12, U5.AA22, U5.AB9, U5.AB19, U5.B3, U5.B4, U5.B7, U5.B9, U5.B19, U5.C1, U5.C5, U5.C7, U5.C16, U5.D3, U5.D4, U5.D7, U5.D13, U5.E1, U5.E5, U5.E7, U5.E10, U5.E20, U5.F3, U5.F4, U5.F7, U5.F17, U5.G1, U5.G5, U5.G14, U5.H3, U5.H4, U5.H5, U5.H6, U5.H11, U5.H21, U5.J1, U5.J2, U5.J3, U5.J5, U5.J8, U5.J10, U5.J12, U5.J14, U5.J18, U5.K5, U5.K9, U5.K11, U5.K13, U5.K15, U5.L2, U5.L8, U5.L10, U5.L11, U5.L12, U5.L14, U5.L22, U5.M7, U5.M9, U5.M11, U5.M12, U5.M13, U5.M15, U5.M19, U5.N6, U5.N8, U5.N10, U5.N11, U5.N12, U5.N14, U5.N16, U5.P3, U5.P9, U5.P11, U5.P13, U5.P15, U5.R8, U5.R10, U5.R12, U5.R14, U5.R20, U5.T7, U5.T17, U5.U4, U5.U14, U5.V1, U5.V11, U5.V21, U5.W8, U5.W18, U5.Y5, U5.Y15, U6.3, U7.3, U8.3, U9.2, U10.13, U10.29, U10.PAD, U11.2, U12.2, U12.5, U13.2, U14.2, U15.4, U16.A1, U17.A1, U18.1, U18.PAD, U19.3
/GTX_1V2: C60.1, C137.1, C140.1, FB5.2, R16.1, TP15.1, U5.A2, U5.C2, U5.E2, U5.G2, U5.H1
/Power Supply/1V0_GOOD: R62.1, TP3.1, U2.19, U2.33, U2.38, U3.C1
/Power Supply/1V0_SENSE: R61.1, U3.F1
/Power Supply/1V2_FB: R5.2, R6.1, U2.20
/Power Supply/1V2_SW: L2.2, U2.22, U2.23
/Power Supply/1V8_FB: R7.2, R8.1, U2.26
/Power Supply/1V35_FB: R2.2, R3.1, U2.1
/Power Supply/1V35_SW: L1.2, U2.3, U2.4, U2.9, U2.10
/Power Supply/3V3_FB: R9.2, R10.1, U2.31
/Power Supply/12V0_FUSED: F1.2, FB1.1
/Power Supply/12V0_RAW: F1.1, J1.1
/Power Supply/LTC_PGOOD: R63.2, TP5.1, U2.15
/Power Supply/PSU_TEMP: TP4.1, U2.36
/Power Supply/VDDQ_SENSE: C125.1, R65.1, U18.5
/Power Supply/VTT_SENSE: C130.1, R66.2, U18.3
/RAM_SCL: U4.202, U5.H14
/RAM_SDA: U4.200, U5.F14
/RAM_VREF: C1.1, C8.1, C126.1, TP7.1, U4.1, U4.126, U5.C20, U5.D14, U5.K17, U5.R19, U5.U20, U5.V17, U18.4
/RAM_VTT: C2.1, C9.1, C15.1, C21.1, C26.1, C129.1, C132.1, R66.1, TP6.1, U4.203, U4.204, U18.8
/RGMII PHY/A1V2: C89.1, C92.1, C96.1, FB3.2, U10.4, U10.9
/RGMII PHY/A1V2_PLL: C90.1, C93.1, FB4.2, U10.44
/RGMII PHY/A3V3: C88.1, C94.1, C95.1, C97.1, FB2.2, U10.1, U10.12, U10.47
/RGMII PHY/CLK_125_AC_N: C71.1, U5.U10
/RGMII PHY/CLK_125_AC_P: C70.1, U5.V9
/RGMII PHY/CLK_125_N: C71.2, U8.5
/RGMII PHY/CLK_125_P: C70.2, U8.4
/RGMII PHY/ETH_A_N: J3.10, U10.3
/RGMII PHY/ETH_A_P: J3.11, U10.2
/RGMII PHY/ETH_B_N: J3.5, U10.6
/RGMII PHY/ETH_B_P: J3.4, U10.5
/RGMII PHY/ETH_CLK_25MHZ: R18.1, U10.46
/RGMII PHY/ETH_C_N: J3.2, U10.8
/RGMII PHY/ETH_C_P: J3.3, U10.7
/RGMII PHY/ETH_D_N: J3.9, U10.11
/RGMII PHY/ETH_D_P: J3.8, U10.10
/RGMII PHY/ETH_LED1_N_1V8: R36.2, U5.U12, U10.17
/RGMII PHY/ETH_LED2_N_1V8: R35.2, U5.U13, U10.15
/RGMII PHY/ETH_MDC: U5.V8, U10.36
/RGMII PHY/ETH_MDIO: R44.2, U5.Y8, U10.37
/RGMII PHY/ETH_RST_N: U5.V7, U10.42
/RGMII PHY/ETH_RXD0: R22.1, R41.2, U5.W11
/RGMII PHY/ETH_RXD1: R21.1, R40.2, U5.W10
/RGMII PHY/ETH_RXD2: R20.1, R39.2, U5.Y11
/RGMII PHY/ETH_RXD3: R19.1, R38.2, U5.U11
/RGMII PHY/ETH_RX_CLK: R24.1, R43.2, U5.W9
/RGMII PHY/ETH_RX_DV: R23.1, R42.2, U5.Y9
/RGMII PHY/LA0_DQ0_N: J9.B3, U5.AB5
/RGMII PHY/LA0_DQ0_P: J9.B2, U5.AA5
/RGMII PHY/LA0_DQ1_N: J9.B6, U5.AB6
/RGMII PHY/LA0_DQ1_P: J9.B5, U5.AA6
/RGMII PHY/LA0_DQ2_N: J9.B14, U5.W6
/RGMII PHY/LA0_DQ2_P: J9.B13, U5.Y6
/RGMII PHY/LA0_DQ3_N: J9.B17, U5.AB8
/RGMII PHY/LA0_DQ3_P: J9.B16, U5.AB7
/RGMII PHY/LA0_DQ4_N: J9.A3, U5.AA9
/RGMII PHY/LA0_DQ4_P: J9.A2, U5.AA8
/RGMII PHY/LA0_DQ5_N: J9.A6, U5.AB10
/RGMII PHY/LA0_DQ5_P: J9.A5, U5.AA10
/RGMII PHY/LA0_DQ6_N: J9.A14, U5.AB11
/RGMII PHY/LA0_DQ6_P: J9.A13, U5.AA11
/RGMII PHY/LA0_DQ7_N: J9.A17, U5.AB13
/RGMII PHY/LA0_DQ7_P: J9.A16, U5.AB12
/RGMII PHY/RGMII_TXD0: U5.AA13, U10.19
/RGMII PHY/RGMII_TXD1: U5.Y13, U10.20
/RGMII PHY/RGMII_TXD2: U5.V13, U10.21
/RGMII PHY/RGMII_TXD3: U5.Y12, U10.22
/RGMII PHY/RGMII_TX_CLK: U5.W12, U10.24
/RGMII PHY/RGMII_TX_EN: U5.V12, U10.25
/SERDES interfaces/GTX_RX1_N: C148.1, U5.G3
/SERDES interfaces/GTX_RX1_P: C147.1, U5.G4
/SERDES interfaces/GTX_RX2_N: C146.1, U5.E3
/SERDES interfaces/GTX_RX2_P: C145.1, U5.E4
/SERDES interfaces/GTX_RX3_AC_N: C37.2, J5.1
/SERDES interfaces/GTX_RX3_AC_P: C36.2, J2.1
/SERDES interfaces/GTX_RX3_N: C37.1, U5.B5
/SERDES interfaces/GTX_RX3_P: C36.1, U5.B6
/SERDES interfaces/GTX_TX1_N: C152.1, U5.F1
/SERDES interfaces/GTX_TX1_P: C151.1, U5.F2
/SERDES interfaces/GTX_TX2_N: C150.1, U5.D2
/SERDES interfaces/GTX_TX2_P: C149.1, U5.D1
/SERDES interfaces/GTX_TX3_AC_N: C34.2, J6.1
/SERDES interfaces/GTX_TX3_AC_P: C35.2, J7.1
/SERDES interfaces/GTX_TX3_N: C34.1, U5.A3
/SERDES interfaces/GTX_TX3_P: C35.1, U5.A4
/SERDES interfaces/REFCLK_156_AC_N: C43.1, U5.D6
/SERDES interfaces/REFCLK_156_AC_P: C42.1, U5.D5
/SERDES interfaces/REFCLK_156_N: C43.2, U6.5
/SERDES interfaces/REFCLK_156_P: C42.2, U6.4
/SERDES interfaces/REFCLK_200_AC_N: C45.1, U5.F6
/SERDES interfaces/REFCLK_200_AC_P: C44.1, U5.F5
/SERDES interfaces/REFCLK_200_N: C45.2, U7.5
/SERDES interfaces/REFCLK_200_P: C44.2, U7.4
/SERDES interfaces/SATA_DEV_RX_N: C148.2, J13.3
/SERDES interfaces/SATA_DEV_RX_P: C147.2, J13.2
/SERDES interfaces/SATA_DEV_TX_N: C152.2, J13.5
/SERDES interfaces/SATA_DEV_TX_P: C151.2, J13.6
/SERDES interfaces/SATA_HOST_RX_N: C146.2, J14.5
/SERDES interfaces/SATA_HOST_RX_P: C145.2, J14.6
/SERDES interfaces/SATA_HOST_TX_N: C150.2, J14.3
/SERDES interfaces/SATA_HOST_TX_P: C149.2, J14.2
/SERDES interfaces/SFP_I2C_SCL: J10.5, R45.2, U5.H13
/SERDES interfaces/SFP_I2C_SDA: J10.4, R46.2, U5.G13
/SERDES interfaces/SFP_RX_N: J10.12, U5.C3
/SERDES interfaces/SFP_RX_P: J10.13, U5.C4
/SERDES interfaces/SFP_TX_N: J10.19, U5.B1
/SERDES interfaces/SFP_TX_P: J10.18, U5.B2
/SERDES interfaces/SFP_VDD_RX: C100.1, C102.1, J10.15, L5.1
/SERDES interfaces/SFP_VDD_TX: C101.1, C103.1, J10.16, L6.1
unnamed: C63.2, J3.17, R17.2
unnamed: C64.2, J3.12
unnamed: C65.2, J3.6
unnamed: C66.2, J3.1
unnamed: C67.2, J3.7
unnamed: C98.1, C99.1, L5.2, L6.2, R50.1
unnamed: C100.2, R51.2
unnamed: C101.2, R52.2
unnamed: D1.1, Q1.D1
unnamed: D1.2, R32.2
unnamed: D2.2, R71.1
unnamed: D3.2, R72.1
unnamed: D4.2, R73.1
unnamed: D5.2, R74.1
unnamed: J3.14, R33.2
unnamed: J3.16, R34.2
unnamed: L3.2, U2.28
unnamed: L4.2, U2.29
unnamed: R1.2, U1.6
unnamed: R4.1, U3.E1
unnamed: R4.2, U3.D1
unnamed: R13.2, U5.H18
unnamed: R14.2, U5.K18
unnamed: R15.2, U5.L16
unnamed: R16.2, U5.H2
unnamed: R18.2, U9.3
unnamed: R19.2, U10.27
unnamed: R20.2, U10.28
unnamed: R21.2, U10.31
unnamed: R22.2, U10.32
unnamed: R23.2, U10.33
unnamed: R24.2, U10.35
unnamed: R25.2, U10.48
unnamed: R26.1, U12.3
unnamed: R30.1, U5.J6
unnamed: R31.1, U5.G7
unnamed: R37.2, U10.41
unnamed: R55.2, R56.1, U16.C1
unnamed: R57.2, R58.1, U17.C1
unnamed: R69.1, U15.3
unnamed: R70.2, U15.7
