azonenberg/sata-sniffer/rtl/vivado-project/sniffer.srcs/constrs_1/new/top.xdc

set_max_delay -datapath_only -from [get_clocks clk_ram_2x_raw] -through [get_nets [list {ethernet/baser_rx_cdc/rx_cdc_fifo/sync_head/reg_a_ff_reg_n_0_[0]} \
          {ethernet/baser_rx_cdc/rx_cdc_fifo/sync_head/reg_a_ff_reg_n_0_[10]} \
          {ethernet/baser_rx_cdc/rx_cdc_fifo/sync_head/reg_a_ff_reg_n_0_[1]} \
          {ethernet/baser_rx_cdc/rx_cdc_fifo/sync_head/reg_a_ff_reg_n_0_[2]} \
          {ethernet/baser_rx_cdc/rx_cdc_fifo/sync_head/reg_a_ff_reg_n_0_[3]} \
          {ethernet/baser_rx_cdc/rx_cdc_fifo/sync_head/reg_a_ff_reg_n_0_[4]} \
          {ethernet/baser_rx_cdc/rx_cdc_fifo/sync_head/reg_a_ff_reg_n_0_[5]} \
          {ethernet/baser_rx_cdc/rx_cdc_fifo/sync_head/reg_a_ff_reg_n_0_[6]} \
          {ethernet/baser_rx_cdc/rx_cdc_fifo/sync_head/reg_a_ff_reg_n_0_[7]} \
          {ethernet/baser_rx_cdc/rx_cdc_fifo/sync_head/reg_a_ff_reg_n_0_[8]} \
          {ethernet/baser_rx_cdc/rx_cdc_fifo/sync_head/reg_a_ff_reg_n_0_[9]} \
          ethernet/baser_rx_cdc/rx_cdc_fifo/sync_head/sync_ack/sync/dout0 \
          ethernet/baser_rx_cdc/rx_cdc_fifo/sync_head/sync_ack/sync/dout0_reg_0 \
          ethernet/baser_rx_cdc/rx_cdc_fifo/sync_head/sync_en/sync/dout0 \
          ethernet/baser_rx_cdc/rx_cdc_fifo/sync_head/sync_en/sync/dout0_reg_0 \
          {ethernet/baser_rx_cdc/rx_cdc_fifo/sync_tail/reg_a_ff__0[0]} \
          {ethernet/baser_rx_cdc/rx_cdc_fifo/sync_tail/reg_a_ff__0[10]} \
          {ethernet/baser_rx_cdc/rx_cdc_fifo/sync_tail/reg_a_ff__0[1]} \
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
          ethernet/cdc/sync_our_mac_addr_baser_txclk/sync_ack/sync/dout0 \
          ethernet/cdc/sync_our_mac_addr_baser_txclk/sync_ack/sync/dout0_reg_0 \
          ethernet/cdc/sync_our_mac_addr_baser_txclk/sync_en/sync/dout0 \
          ethernet/cdc/sync_our_mac_addr_baser_txclk/sync_en/sync/dout0_reg_0 \
          ethernet/cdc/sync_our_mac_addr_baset_txclk/sync_ack/sync/dout0 \
          ethernet/cdc/sync_our_mac_addr_baset_txclk/sync_ack/sync/dout0_reg_0 \
          ethernet/cdc/sync_our_mac_addr_baset_txclk/sync_en/sync/dout0 \
          ethernet/cdc/sync_our_mac_addr_baset_txclk/sync_en/sync/dout0_reg_0 \
          ethernet/cdc/sync_our_mac_addr_clk_ipstack/sync_ack/sync/dout0 \
          ethernet/cdc/sync_our_mac_addr_clk_ipstack/sync_ack/sync/dout0_reg_0 \
          ethernet/cdc/sync_our_mac_addr_clk_ipstack/sync_en/sync/dout0 \
          ethernet/cdc/sync_our_mac_addr_clk_ipstack/sync_en/sync/dout0_reg_0 \
          ethernet/rgmii/gig_mac_wrapper/mac/dout0_reg \
          ethernet/rgmii/gig_mac_wrapper/mac/sync_link_speed/dout0_reg \
          ethernet/rgmii/gig_mac_wrapper/mac/sync_link_speed/sync_ack/sync/dout0 \
          ethernet/rgmii/gig_mac_wrapper/mac/sync_link_speed/sync_ack/sync/dout0_reg_0 \
          ethernet/rgmii/gig_mac_wrapper/mac/sync_link_speed/sync_en/dout0_reg \
          ethernet/rgmii/gig_mac_wrapper/mac/sync_link_speed/sync_en/sync/dout0 \
          ethernet/rgmii/gig_mac_wrapper/mac/sync_link_speed/sync_en/sync/dout0_reg_0 \
          ethernet/rgmii/gig_mac_wrapper/mac/sync_link_speed/sync_en/sync/dout0_reg_1 \
          {ethernet/rgmii/gig_mac_wrapper/rgmii_bridge/rgmii_rxd_iddr2/dout0[0]} \
          {ethernet/rgmii/gig_mac_wrapper/rgmii_bridge/rgmii_rxd_iddr2/dout0[1]} \
          {ethernet/rgmii/gig_mac_wrapper/rgmii_bridge/rgmii_rxd_iddr2/dout0[2]} \
          {ethernet/rgmii/gig_mac_wrapper/rgmii_bridge/rgmii_rxd_iddr2/dout0[3]} \
          ethernet/rgmii/gig_mac_wrapper/rgmii_bridge/sync_link_speed/dout0_reg \
          {ethernet/rgmii/gig_mac_wrapper/rgmii_bridge/sync_link_speed/reg_a_ff_reg[0]_0} \
          {ethernet/rgmii/gig_mac_wrapper/rgmii_bridge/sync_link_speed/reg_a_ff_reg[1]_0[0]} \
          {ethernet/rgmii/gig_mac_wrapper/rgmii_bridge/sync_link_speed/reg_a_ff_reg[1]_0[1]} \
          {ethernet/rgmii/gig_mac_wrapper/rgmii_bridge/sync_link_speed/reg_a_ff_reg[1]_1} \
          ethernet/rgmii/gig_mac_wrapper/rgmii_bridge/sync_link_speed/sync_ack/sync/dout0 \
          ethernet/rgmii/gig_mac_wrapper/rgmii_bridge/sync_link_speed/sync_ack/sync/dout0_reg_0 \
          ethernet/rgmii/gig_mac_wrapper/rgmii_bridge/sync_link_speed/sync_en/dout0_reg \
          ethernet/rgmii/gig_mac_wrapper/rgmii_bridge/sync_link_speed/sync_en/sync/dout0 \
          ethernet/rgmii/gig_mac_wrapper/rgmii_bridge/sync_link_speed/sync_en/sync/dout0_reg_0 \
          ethernet/sfp/pcs/sync_sfp_los/dout0 \
          ethernet/sfp/pcs/sync_sfp_los/dout0_reg \
          ethernet/sfp/pcs/sync_sfp_los/dout0_reg_0 \
          ethernet/sync_baser_link_up/dout0 \
          ethernet/sync_baset_link_up/dout0 \
          {ethernet/tx_arbiter/arp_header_fifo/sync_head/reg_a_ff_reg_n_0_[0]} \
          {ethernet/tx_arbiter/arp_header_fifo/sync_head/reg_a_ff_reg_n_0_[1]} \
          {ethernet/tx_arbiter/arp_header_fifo/sync_head/reg_a_ff_reg_n_0_[2]} \
          {ethernet/tx_arbiter/arp_header_fifo/sync_head/reg_a_ff_reg_n_0_[3]} \
          {ethernet/tx_arbiter/arp_header_fifo/sync_head/reg_a_ff_reg_n_0_[4]} \
          ethernet/tx_arbiter/arp_header_fifo/sync_head/sync_ack/sync/dout0 \
          ethernet/tx_arbiter/arp_header_fifo/sync_head/sync_ack/sync/dout0_reg_0 \
          ethernet/tx_arbiter/arp_header_fifo/sync_head/sync_en/sync/dout0 \
          ethernet/tx_arbiter/arp_header_fifo/sync_head/sync_en/sync/dout0_reg_0 \
          {ethernet/tx_arbiter/arp_header_fifo/sync_tail/reg_a_ff_reg[4]_0[0]} \
          {ethernet/tx_arbiter/arp_header_fifo/sync_tail/reg_a_ff_reg[4]_0[1]} \
          {ethernet/tx_arbiter/arp_header_fifo/sync_tail/reg_a_ff_reg[4]_0[2]} \
          {ethernet/tx_arbiter/arp_header_fifo/sync_tail/reg_a_ff_reg[4]_0[3]} \
          {ethernet/tx_arbiter/arp_header_fifo/sync_tail/reg_a_ff_reg[4]_0[4]} \
          {ethernet/tx_arbiter/arp_header_fifo/sync_tail/reg_a_ff_reg_n_0_[0]} \
          {ethernet/tx_arbiter/arp_header_fifo/sync_tail/reg_a_ff_reg_n_0_[1]} \
          {ethernet/tx_arbiter/arp_header_fifo/sync_tail/reg_a_ff_reg_n_0_[2]} \
          {ethernet/tx_arbiter/arp_header_fifo/sync_tail/reg_a_ff_reg_n_0_[3]} \
          {ethernet/tx_arbiter/arp_header_fifo/sync_tail/reg_a_ff_reg_n_0_[4]} \
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
          {la/la1_path/genblk3[7].cdc_fifo/sync_wr_ptr/reg_a_ff_reg[9]_0[7]} \
          {la/la1_path/genblk3[7].cdc_fifo/sync_wr_ptr/reg_a_ff_reg[9]_0[8]} \
          {la/la1_path/genblk3[7].cdc_fifo/sync_wr_ptr/reg_a_ff_reg[9]_0[9]} \
          {la/la1_path/genblk3[7].cdc_fifo/sync_wr_ptr/sync_ack/sync/dout0} \
          {la/la1_path/genblk3[7].cdc_fifo/sync_wr_ptr/sync_ack/sync/dout0_reg_0} \
          {la/la1_path/genblk3[7].cdc_fifo/sync_wr_ptr/sync_en/dout0_reg} \
          {la/la1_path/genblk3[7].cdc_fifo/sync_wr_ptr/sync_en/sync/dout0} \
          {la/la1_path/genblk3[7].cdc_fifo/sync_wr_ptr/sync_en/sync/dout0_reg_0} \
          {la/la1_path/genblk3[7].sync_deser_flush_done/dout0_reg} \
          {la/la1_path/genblk3[7].sync_deser_flush_done/sync/dout0} \
          {la/la1_path/genblk3[7].sync_deser_flush_done/sync/dout0_reg_0} \
          {la/la1_path/genblk3[7].sync_deser_flush_done/sync/dout0_reg_1} \
          la/la1_path/sync_armed/dout0 \
          la/trig/sync_en_la0/dout0 \
          la/trig/sync_en_la1/dout0 \
          la/trig/sync_flush_arbiter/sync/dout0 \
          la/trig/sync_flush_arbiter/sync/dout0_reg_0 \
          la/trig/sync_flush_la0/sync/dout0 \
          la/trig/sync_flush_la1/sync/dout0 \
          la/trig/sync_flush_la1/sync/dout0_reg_0 \
          la/trig/sync_rst_arbiter/dout0 \
          la/trig/sync_rst_la0/dout0 \
          la/trig/sync_rst_la1/dout0 \
          {mcu/qspi/genblk1[0].sync_dq/dout0} \
          {mcu/qspi/genblk1[1].sync_dq/dout0} \
          {mcu/qspi/genblk1[2].sync_dq/dout0} \
          {mcu/qspi/genblk1[3].sync_dq/dout0} \
          mcu/qspi/sync_cs/dout0 \
          mcu/qspi/sync_sck/dout0 \
          mem/arbiter/dout0_reg \
          mem/arbiter/cmd_addr_fifo/dout0_reg \
          {mem/arbiter/cmd_addr_fifo/sync_rd_ptr/reg_a_ff_reg_n_0_[0]} \
          {mem/arbiter/cmd_addr_fifo/sync_rd_ptr/reg_a_ff_reg_n_0_[1]} \
          {mem/arbiter/cmd_addr_fifo/sync_rd_ptr/reg_a_ff_reg_n_0_[2]} \
          {mem/arbiter/cmd_addr_fifo/sync_rd_ptr/reg_a_ff_reg_n_0_[3]} \
          {mem/arbiter/cmd_addr_fifo/sync_rd_ptr/reg_a_ff_reg_n_0_[4]} \
          {mem/arbiter/cmd_addr_fifo/sync_rd_ptr/reg_a_ff_reg_n_0_[5]} \
          {mem/arbiter/cmd_addr_fifo/sync_rd_ptr/reg_a_ff_reg_n_0_[6]} \
          {mem/arbiter/cmd_addr_fifo/sync_rd_ptr/reg_a_ff_reg_n_0_[7]} \
          {mem/arbiter/cmd_addr_fifo/sync_rd_ptr/reg_a_ff_reg_n_0_[8]} \
          mem/arbiter/cmd_addr_fifo/sync_rd_ptr/sync_ack/dout0_reg \
          mem/arbiter/cmd_addr_fifo/sync_rd_ptr/sync_ack/sync/dout0 \
          mem/arbiter/cmd_addr_fifo/sync_rd_ptr/sync_ack/sync/dout0_reg_0 \
          mem/arbiter/cmd_addr_fifo/sync_rd_ptr/sync_ack/sync/dout0_reg_1 \
          mem/arbiter/cmd_addr_fifo/sync_rd_ptr/sync_en/sync/dout0 \
          mem/arbiter/cmd_addr_fifo/sync_rd_ptr/sync_en/sync/dout0_reg_0 \
          mem/arbiter/cmd_addr_fifo/sync_wr_ptr/dout0_reg \
          {mem/arbiter/cmd_addr_fifo/sync_wr_ptr/reg_a_ff_reg_n_0_[0]} \
          {mem/arbiter/cmd_addr_fifo/sync_wr_ptr/reg_a_ff_reg_n_0_[1]} \
          {mem/arbiter/cmd_addr_fifo/sync_wr_ptr/reg_a_ff_reg_n_0_[2]} \
          {mem/arbiter/cmd_addr_fifo/sync_wr_ptr/reg_a_ff_reg_n_0_[3]} \
          {mem/arbiter/cmd_addr_fifo/sync_wr_ptr/reg_a_ff_reg_n_0_[4]} \
          {mem/arbiter/cmd_addr_fifo/sync_wr_ptr/reg_a_ff_reg_n_0_[5]} \
          {mem/arbiter/cmd_addr_fifo/sync_wr_ptr/reg_a_ff_reg_n_0_[6]} \
          {mem/arbiter/cmd_addr_fifo/sync_wr_ptr/reg_a_ff_reg_n_0_[7]} \
          {mem/arbiter/cmd_addr_fifo/sync_wr_ptr/reg_a_ff_reg_n_0_[8]} \
          mem/arbiter/cmd_addr_fifo/sync_wr_ptr/sync_ack/sync/dout0 \
          mem/arbiter/cmd_addr_fifo/sync_wr_ptr/sync_ack/sync/dout0_reg_0 \
          mem/arbiter/cmd_addr_fifo/sync_wr_ptr/sync_en/dout0_reg \
          mem/arbiter/cmd_addr_fifo/sync_wr_ptr/sync_en/sync/dout0 \
          mem/arbiter/cmd_addr_fifo/sync_wr_ptr/sync_en/sync/dout0_reg_0 \
          mem/arbiter/cmd_addr_fifo/sync_wr_ptr/sync_en/sync/dout0_reg_1 \
          mem/arbiter/wr_data_fifo/dout0_reg \
          {mem/arbiter/wr_data_fifo/sync_rd_ptr/reg_a_ff_reg[9]_0[0]} \
          {mem/arbiter/wr_data_fifo/sync_rd_ptr/reg_a_ff_reg[9]_0[1]} \
          {mem/arbiter/wr_data_fifo/sync_rd_ptr/reg_a_ff_reg[9]_0[2]} \
          {mem/arbiter/wr_data_fifo/sync_rd_ptr/reg_a_ff_reg[9]_0[3]} \
          {mem/arbiter/wr_data_fifo/sync_rd_ptr/reg_a_ff_reg[9]_0[4]} \
          {mem/arbiter/wr_data_fifo/sync_rd_ptr/reg_a_ff_reg[9]_0[5]} \
          {mem/arbiter/wr_data_fifo/sync_rd_ptr/reg_a_ff_reg[9]_0[6]} \
          {mem/arbiter/wr_data_fifo/sync_rd_ptr/reg_a_ff_reg[9]_0[7]} \
          {mem/arbiter/wr_data_fifo/sync_rd_ptr/reg_a_ff_reg[9]_0[8]} \
          {mem/arbiter/wr_data_fifo/sync_rd_ptr/reg_a_ff_reg[9]_0[9]} \
          {mem/arbiter/wr_data_fifo/sync_rd_ptr/reg_a_ff_reg_n_0_[0]} \
          {mem/arbiter/wr_data_fifo/sync_rd_ptr/reg_a_ff_reg_n_0_[1]} \
          {mem/arbiter/wr_data_fifo/sync_rd_ptr/reg_a_ff_reg_n_0_[2]} \
          {mem/arbiter/wr_data_fifo/sync_rd_ptr/reg_a_ff_reg_n_0_[3]} \
          {mem/arbiter/wr_data_fifo/sync_rd_ptr/reg_a_ff_reg_n_0_[4]} \
          {mem/arbiter/wr_data_fifo/sync_rd_ptr/reg_a_ff_reg_n_0_[5]} \
          {mem/arbiter/wr_data_fifo/sync_rd_ptr/reg_a_ff_reg_n_0_[6]} \
          {mem/arbiter/wr_data_fifo/sync_rd_ptr/reg_a_ff_reg_n_0_[7]} \
          {mem/arbiter/wr_data_fifo/sync_rd_ptr/reg_a_ff_reg_n_0_[8]} \
          {mem/arbiter/wr_data_fifo/sync_rd_ptr/reg_a_ff_reg_n_0_[9]} \
          mem/arbiter/wr_data_fifo/sync_rd_ptr/sync_ack/dout0_reg \
          mem/arbiter/wr_data_fifo/sync_rd_ptr/sync_ack/sync/dout0 \
          mem/arbiter/wr_data_fifo/sync_rd_ptr/sync_ack/sync/dout0_reg_0 \
          mem/arbiter/wr_data_fifo/sync_rd_ptr/sync_ack/sync/dout0_reg_1 \
          mem/arbiter/wr_data_fifo/sync_rd_ptr/sync_en/sync/dout0 \
          mem/arbiter/wr_data_fifo/sync_rd_ptr/sync_en/sync/dout0_reg_0 \
          mem/arbiter/wr_data_fifo/sync_wr_ptr/dout0_reg \
          {mem/arbiter/wr_data_fifo/sync_wr_ptr/reg_a_ff[0]} \
          {mem/arbiter/wr_data_fifo/sync_wr_ptr/reg_a_ff[1]} \
          {mem/arbiter/wr_data_fifo/sync_wr_ptr/reg_a_ff[2]} \
          {mem/arbiter/wr_data_fifo/sync_wr_ptr/reg_a_ff[3]} \
          {mem/arbiter/wr_data_fifo/sync_wr_ptr/reg_a_ff[4]} \
          {mem/arbiter/wr_data_fifo/sync_wr_ptr/reg_a_ff[5]} \
          {mem/arbiter/wr_data_fifo/sync_wr_ptr/reg_a_ff[6]} \
          {mem/arbiter/wr_data_fifo/sync_wr_ptr/reg_a_ff[7]} \
          {mem/arbiter/wr_data_fifo/sync_wr_ptr/reg_a_ff[8]} \
          {mem/arbiter/wr_data_fifo/sync_wr_ptr/reg_a_ff[9]} \
          mem/arbiter/wr_data_fifo/sync_wr_ptr/sync_ack/sync/dout0 \
          mem/arbiter/wr_data_fifo/sync_wr_ptr/sync_ack/sync/dout0_reg_0 \
          mem/arbiter/wr_data_fifo/sync_wr_ptr/sync_en/dout0_reg \
          mem/arbiter/wr_data_fifo/sync_wr_ptr/sync_en/sync/dout0 \
          mem/arbiter/wr_data_fifo/sync_wr_ptr/sync_en/sync/dout0_reg_0]] -to [get_clocks clk_ram] 3.200
set_max_delay -datapath_only -from [get_clocks clk_ram] -through [get_nets [list {ethernet/baser_rx_cdc/rx_cdc_fifo/sync_head/reg_a_ff_reg_n_0_[0]} \
          {ethernet/baser_rx_cdc/rx_cdc_fifo/sync_head/reg_a_ff_reg_n_0_[10]} \
          {ethernet/baser_rx_cdc/rx_cdc_fifo/sync_head/reg_a_ff_reg_n_0_[1]} \
          {ethernet/baser_rx_cdc/rx_cdc_fifo/sync_head/reg_a_ff_reg_n_0_[2]} \
          {ethernet/baser_rx_cdc/rx_cdc_fifo/sync_head/reg_a_ff_reg_n_0_[3]} \
          {ethernet/baser_rx_cdc/rx_cdc_fifo/sync_head/reg_a_ff_reg_n_0_[4]} \
          {ethernet/baser_rx_cdc/rx_cdc_fifo/sync_head/reg_a_ff_reg_n_0_[5]} \
          {ethernet/baser_rx_cdc/rx_cdc_fifo/sync_head/reg_a_ff_reg_n_0_[6]} \
          {ethernet/baser_rx_cdc/rx_cdc_fifo/sync_head/reg_a_ff_reg_n_0_[7]} \
          {ethernet/baser_rx_cdc/rx_cdc_fifo/sync_head/reg_a_ff_reg_n_0_[8]} \
          {ethernet/baser_rx_cdc/rx_cdc_fifo/sync_head/reg_a_ff_reg_n_0_[9]} \
          ethernet/baser_rx_cdc/rx_cdc_fifo/sync_head/sync_ack/sync/dout0 \
          mem/arbiter/wr_data_fifo/sync_wr_ptr/sync_en/sync/dout0_reg_0 \
          ethernet/baser_rx_cdc/rx_cdc_fifo/sync_head/sync_en/sync/dout0 \
          ethernet/baser_rx_cdc/rx_cdc_fifo/sync_head/sync_en/sync/dout0_reg_0 \
          {ethernet/baser_rx_cdc/rx_cdc_fifo/sync_tail/reg_a_ff__0[0]} \
          {ethernet/baser_rx_cdc/rx_cdc_fifo/sync_tail/reg_a_ff__0[10]} \
          {ethernet/baser_rx_cdc/rx_cdc_fifo/sync_tail/reg_a_ff__0[1]} \
          {ethernet/baser_rx_cdc/rx_cdc_fifo/sync_tail/reg_a_ff__0[2]} \
          {ethernet/baser_rx_cdc/rx_cdc_fifo/sync_tail/reg_a_ff__0[3]} \
          {ethernet/baser_rx_cdc/rx_cdc_fifo/sync_tail/reg_a_ff__0[4]} \
          {ethernet/baser_rx_cdc/rx_cdc_fifo/sync_tail/reg_a_ff__0[5]} \
          {ethernet/baser_rx_cdc/rx_cdc_fifo/sync_tail/reg_a_ff__0[6]} \
          {ethernet/baser_rx_cdc/rx_cdc_fifo/sync_tail/reg_a_ff__0[7]} \
          {ethernet/baser_rx_cdc/rx_cdc_fifo/sync_tail/reg_a_ff__0[8]} \
          {ethernet/baser_rx_cdc/rx_cdc_fifo/sync_tail/reg_a_ff__0[9]} \
          ethernet/baser_rx_cdc/rx_cdc_fifo/sync_tail/sync_ack/sync/dout0 \
          ethernet/baser_rx_cdc/rx_cdc_fifo/sync_tail/sync_ack/sync/dout0_reg_0 \
          ethernet/baser_rx_cdc/rx_cdc_fifo/sync_tail/sync_en/sync/dout0 \
          {ethernet/baset_rx_cdc/rx_cdc_fifo/sync_head/reg_a_ff_reg_n_0_[0]} \
          {ethernet/baset_rx_cdc/rx_cdc_fifo/sync_head/reg_a_ff_reg_n_0_[10]} \
          {ethernet/baset_rx_cdc/rx_cdc_fifo/sync_head/reg_a_ff_reg_n_0_[1]} \
          {ethernet/baset_rx_cdc/rx_cdc_fifo/sync_head/reg_a_ff_reg_n_0_[2]} \
          {ethernet/baset_rx_cdc/rx_cdc_fifo/sync_head/reg_a_ff_reg_n_0_[3]} \
          {ethernet/baset_rx_cdc/rx_cdc_fifo/sync_head/reg_a_ff_reg_n_0_[4]} \
          {ethernet/baset_rx_cdc/rx_cdc_fifo/sync_head/reg_a_ff_reg_n_0_[5]} \
          {ethernet/baset_rx_cdc/rx_cdc_fifo/sync_head/reg_a_ff_reg_n_0_[6]} \
          {ethernet/baset_rx_cdc/rx_cdc_fifo/sync_head/reg_a_ff_reg_n_0_[7]} \
          {ethernet/baset_rx_cdc/rx_cdc_fifo/sync_head/reg_a_ff_reg_n_0_[8]} \
          {ethernet/baset_rx_cdc/rx_cdc_fifo/sync_head/reg_a_ff_reg_n_0_[9]} \
          ethernet/baset_rx_cdc/rx_cdc_fifo/sync_head/sync_ack/sync/dout0 \
          ethernet/baset_rx_cdc/rx_cdc_fifo/sync_head/sync_ack/sync/dout0_reg_0 \
          ethernet/baset_rx_cdc/rx_cdc_fifo/sync_head/sync_en/sync/dout0 \
          ethernet/baset_rx_cdc/rx_cdc_fifo/sync_head/sync_en/sync/dout0_reg_0 \
          {ethernet/baset_rx_cdc/rx_cdc_fifo/sync_tail/reg_a_ff[0]} \
          {ethernet/baset_rx_cdc/rx_cdc_fifo/sync_tail/reg_a_ff[10]} \
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
          {ethernet/cdc/sync_ip_config_clk_ipstack/reg_a_ff_reg_n_0_[123]} \
          {ethernet/cdc/sync_ip_config_clk_ipstack/reg_a_ff_reg_n_0_[124]} \
          {ethernet/cdc/sync_ip_config_clk_ipstack/reg_a_ff_reg_n_0_[125]} \
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
