azonenberg/sata-sniffer/rtl/mem/MemoryArbiter.sv

`timescale 1ns / 1ps
`default_nettype none
/***********************************************************************************************************************
*                                                                                                                      *
* sata-sniffer v0.1                                                                                                    *
*                                                                                                                      *
* Copyright (c) 2021-2022 Andrew D. Zonenberg and contributors                                                         *
* All rights reserved.                                                                                                 *
*                                                                                                                      *
* Redistribution and use in source and binary forms, with or without modification, are permitted provided that the     *
* following conditions are met:                                                                                        *
*                                                                                                                      *
*    * Redistributions of source code must retain the above copyright notice, this list of conditions, and the         *
*      following disclaimer.                                                                                           *
*                                                                                                                      *
*    * Redistributions in binary form must reproduce the above copyright notice, this list of conditions and the       *
*      following disclaimer in the documentation and/or other materials provided with the distribution.                *
*                                                                                                                      *
*    * Neither the name of the author nor the names of any contributors may be used to endorse or promote products     *
*      derived from this software without specific prior written permission.                                           *
*                                                                                                                      *
* THIS SOFTWARE IS PROVIDED BY THE AUTHORS "AS IS" AND ANY EXPRESS OR IMPLIED WARRANTIES, INCLUDING, BUT NOT LIMITED   *
* TO, THE IMPLIED WARRANTIES OF MERCHANTABILITY AND FITNESS FOR A PARTICULAR PURPOSE ARE DISCLAIMED. IN NO EVENT SHALL *
* THE AUTHORS BE HELD LIABLE FOR ANY DIRECT, INDIRECT, INCIDENTAL, SPECIAL, EXEMPLARY, OR CONSEQUENTIAL DAMAGES        *
* (INCLUDING, BUT NOT LIMITED TO, PROCUREMENT OF SUBSTITUTE GOODS OR SERVICES; LOSS OF USE, DATA, OR PROFITS; OR       *
* BUSINESS INTERRUPTION) HOWEVER CAUSED AND ON ANY THEORY OF LIABILITY, WHETHER IN CONTRACT, STRICT LIABILITY, OR TORT *
* (INCLUDING NEGLIGENCE OR OTHERWISE) ARISING IN ANY WAY OUT OF THE USE OF THIS SOFTWARE, EVEN IF ADVISED OF THE       *
* POSSIBILITY OF SUCH DAMAGE.                                                                                          *
*                                                                                                                      *
***********************************************************************************************************************/

module MemoryArbiter(

	//Top level clock
	input wire			clk_ram,
	input wire			clk_ram_2x,

	//Bus to memory controller
	output logic[28:0]	app_addr		= 0,
	output logic[2:0]	app_cmd			= 0,
	output logic		app_en			= 0,

	output logic[255:0]	app_wdf_data	= 0,
	output logic		app_wdf_end		= 0,
	output logic[31:0]	app_wdf_mask	= 0,	//default to not masking anything
	output logic		app_wdf_wren	= 0,
	input wire			app_wdf_rdy,

	output logic		app_ref_req		= 0,
	output logic		app_sr_req		= 0,
	output logic		app_zq_req		= 0,

	input wire[255:0]	app_rd_data,
	input wire			app_rd_data_end,
	input wire			app_rd_data_valid,

	input wire			app_rdy,

	//Buses from client domains to arbiter
	//128 bits at 2x controller clock
	//TODO: we could simplify things a lot by running the entire controller at this rate??

	output wire			la0_ram_data_rd_en,
	input wire[127:0]	la0_ram_data_rd_data,
	input wire[9:0]		la0_ram_data_rd_size,
	output wire			la0_ram_addr_rd_en,
	input wire[28:0]	la0_ram_addr_rd_data,
	input wire[7:0]		la0_ram_addr_rd_size,

	output wire			la1_ram_data_rd_en,
	input wire[127:0]	la1_ram_data_rd_data,
	input wire[9:0]		la1_ram_data_rd_size,
	output wire			la1_ram_addr_rd_en,
	input wire[28:0]	la1_ram_addr_rd_data,
	input wire[7:0]		la1_ram_addr_rd_size,

	output wire			la_readback_ram_addr_rd_en,
	input wire[28:0]	la_readback_ram_addr_rd_data,
	input wire[7:0]		la_readback_ram_addr_rd_size,

	//Control signals
	input wire			trig_rst_arbiter,			//clk_ram
	input wire			capture_flush_arbiter,

	input wire			trig_rst_arbiter_2x,		//clk_ram_2x
	input wire			flush_arbiter_2x,
	input wire			la0_flush_complete,
	input wire			la1_flush_complete,
	output logic		flush_done	= 0
);

	////////////////////////////////////////////////////////////////////////////////////////////////////////////////////
	// Remap I/Os to numbered vectors for easier handling

	localparam NUM_PORTS = 3;

	logic[NUM_PORTS-1:0]	idata_rd_en	= 0;
	assign la0_ram_data_rd_en = idata_rd_en[0];
	assign la1_ram_data_rd_en = idata_rd_en[1];
									//port 2 is read only

	logic[127:0]			idata_rd_data[NUM_PORTS-1:0];
	assign idata_rd_data[0] = la0_ram_data_rd_data;
	assign idata_rd_data[1] = la1_ram_data_rd_data;
	assign idata_rd_data[2] = 0;	//port 2 is read only

	logic[9:0]				idata_rd_size[NUM_PORTS-1:0];
	assign idata_rd_size[0] = la0_ram_data_rd_size;
	assign idata_rd_size[1] = la1_ram_data_rd_size;
	assign idata_rd_size[2] = 0;	//port 2 is read only

	logic[NUM_PORTS-1:0]	iaddr_rd_en	= 0;
	assign la0_ram_addr_rd_en = iaddr_rd_en[0];
	assign la1_ram_addr_rd_en = iaddr_rd_en[1];
	assign la_readback_ram_addr_rd_en = iaddr_rd_en[2];

	logic[28:0]				iaddr_rd_data[NUM_PORTS-1:0];
	assign iaddr_rd_data[0] = la0_ram_addr_rd_data;
	assign iaddr_rd_data[1] = la1_ram_addr_rd_data;
	assign iaddr_rd_data[2] = la_readback_ram_addr_rd_data;

	logic[7:0]				iaddr_rd_size[NUM_PORTS-1:0];
	assign iaddr_rd_size[0] = la0_ram_addr_rd_size;
	assign iaddr_rd_size[1] = la1_ram_addr_rd_size;
	assign iaddr_rd_size[2] = la_readback_ram_addr_rd_size;

	////////////////////////////////////////////////////////////////////////////////////////////////////////////////////
	// Arbitration and deserialization to a single 256 bit stream in the 2x clock domain

	//Round robin, then pick first available port if selected port is unavailable
	localparam PORT_BITS = $clog2(NUM_PORTS);
	logic[PORT_BITS-1:0]	rr_source		= 0;
	logic[PORT_BITS-1:0]	current_source;

	logic[2:0]				burst_count		= 0;
	logic					rd_phase		= 0;

	wire[9:0]				data_fifo_wr_size;
	wire[8:0]				addr_fifo_wr_size;
	logic					output_almost_full;

	logic[NUM_PORTS-1:0]	input_data_ready	= 0;

	logic					iaddr_rd_valid_adv	= 0;
	logic					iaddr_rd_valid		= 0;
	logic					idata_rd_valid_adv	= 0;
	logic					idata_rd_valid		= 0;

	logic					data_fifo_wr_en		= 0;
	logic					addr_fifo_wr_en		= 0;

	logic[127:0]			idata_rd_muxed;
	logic[28:0]				iaddr_rd_muxed;

	logic[29:0]				addr_fifo_wr_data;
	logic[255:0]			data_fifo_wr_data;

	always_comb begin

		//Make sure we have room in the output
		output_almost_full		= (data_fifo_wr_size < 5) || (addr_fifo_wr_size < 2);

		//Main read muxes
		idata_rd_muxed			= idata_rd_data[current_source];
		iaddr_rd_muxed			= iaddr_rd_data[current_source];

	end

	enum logic
	{
		MIG_CMD_READ	= 1'b1,
		MIG_CMD_WRITE	= 1'b0
	} mig_cmd_t;

	logic	can_start_burst;

	always_comb begin

		//Can't do anything if no space in output
		if(output_almost_full)
			 can_start_burst = 0;

		//Can start a new burst if idle, or in the last cycle of an existing one
		else if( (burst_count == 0) || (burst_count == 4) )
			can_start_burst = 1;

		//Nope, busy with an existing burst
		else
			can_start_burst = 0;

	end

	logic	hit = 0;
	always_ff @(posedge clk_ram_2x) begin

		//Check if there's something to read on the input
		for(integer i=0; i<NUM_PORTS; i=i+1) begin
			input_data_ready[i]	<= (idata_rd_size[i] >= 4) && (iaddr_rd_size[i] >= 1);

			//port 2 is read only
			if(i == 2)
				input_data_ready[i]	<= (iaddr_rd_size[i] >= 1);
		end

		//Default flags to off
		idata_rd_en				<= 0;
		iaddr_rd_en				<= 0;
		data_fifo_wr_en			<= 0;
		addr_fifo_wr_en			<= 0;

		//Pipeline valid flags
		iaddr_rd_valid_adv		<= (iaddr_rd_en != 0);
		iaddr_rd_valid			<= iaddr_rd_valid_adv;
		idata_rd_valid_adv		<= (idata_rd_en != 0);
		idata_rd_valid			<= idata_rd_valid_adv;

		//Bump round robin counter if starting a burst
		if(burst_count == 1) begin
			rr_source		<= rr_source + 1;
			if( (rr_source + 1) >= NUM_PORTS)
				rr_source	<= 0;
		end

		//Keep track of position in a burst
		if(burst_count > 0) begin
			burst_count	<= burst_count + 1;
			if(burst_count == 4)
				burst_count	<= 0;
			else
				idata_rd_en[current_source]	<= 1;
		end

		//Ready to start a new burst?
		if(can_start_burst) begin

			hit = 0;

			//Check if the round robin winner wants to send
			if(input_data_ready[rr_source]) begin
				hit 					= 1;
				current_source			= rr_source;
			end

			//Check if anyone else wants to send
			else begin
				for(integer i=0; i<NUM_PORTS; i=i+1) begin
					if(!hit && input_data_ready[i]) begin
						hit 			= 1;
						current_source	= i;
					end

				end
			end

			//If somebody wants to send, make it happen
			if(hit) begin
				idata_rd_en[current_source]	<= 1;
				iaddr_rd_en[current_source]	<= 1;
				burst_count					<= 1;
			end

		end

		//Push address/command to the FIFO
		if(iaddr_rd_valid) begin
			addr_fifo_wr_en			<= 1;
			if(current_source == 2)
				addr_fifo_wr_data	<= { MIG_CMD_READ, iaddr_rd_muxed };
			else
				addr_fifo_wr_data	<= { MIG_CMD_WRITE, iaddr_rd_muxed };
		end

		//Push data to the FIFO
		if(idata_rd_valid) begin
			rd_phase			<= !rd_phase;
			data_fifo_wr_data	<= { data_fifo_wr_data[127:0], idata_rd_muxed };
			if(rd_phase && (current_source != 2) )
				data_fifo_wr_en	<= 1;
		end

	end

	////////////////////////////////////////////////////////////////////////////////////////////////////////////////////
	// CDC FIFOs from fast to slow clock domain

	wire[255:0]		fifo_rd_data;
	wire[9:0]		data_fifo_rd_size;
	logic			data_fifo_rd_en	= 0;

	localparam DATA_FIFO_DEPTH = 512;

	CrossClockFifo #(
		.WIDTH(256),
		.DEPTH(DATA_FIFO_DEPTH),
		.USE_BLOCK(1),
		.OUT_REG(1)
	) wr_data_fifo (
		.wr_clk(clk_ram_2x),
		.wr_en(data_fifo_wr_en),
		.wr_data(data_fifo_wr_data),
		.wr_size(data_fifo_wr_size),
		.wr_full(),
		.wr_overflow(),
		.wr_reset(1'b0),

		.rd_clk(clk_ram),
		.rd_en(data_fifo_rd_en),
		.rd_data(fifo_rd_data),
		.rd_size(data_fifo_rd_size),
		.rd_empty(),
		.rd_underflow(),
		.rd_reset(1'b0)
	);

	wire			fifo_rd_cmd;
	wire[28:0]		fifo_rd_addr;

	wire[8:0]		cmd_addr_fifo_rd_size;
	logic			cmd_addr_fifo_rd_en	= 0;
	wire			cmd_addr_fifo_empty;
	localparam ADDR_FIFO_DEPTH = DATA_FIFO_DEPTH / 2;
	CrossClockFifo #(
		.WIDTH(30),
		.DEPTH(ADDR_FIFO_DEPTH),
		.USE_BLOCK(1),
		.OUT_REG(1)
	) cmd_addr_fifo (
		.wr_clk(clk_ram_2x),
		.wr_en(addr_fifo_wr_en),
		.wr_data(addr_fifo_wr_data),
		.wr_size(addr_fifo_wr_size),
		.wr_full(),
		.wr_overflow(),
		.wr_reset(1'b0),

		.rd_clk(clk_ram),
		.rd_en(cmd_addr_fifo_rd_en),
		.rd_data({fifo_rd_cmd, fifo_rd_addr}),
		.rd_size(cmd_addr_fifo_rd_size),
		.rd_empty(cmd_addr_fifo_empty),
		.rd_underflow(),
		.rd_reset(1'b0)
	);

	////////////////////////////////////////////////////////////////////////////////////////////////////////////////////
	// Keep track of what's been flushed

	enum logic[2:0]
	{
		FLUSH_STATE_IDLE	 		= 0,
		FLUSH_STATE_POD_WAIT		= 1,
		FLUSH_STATE_POD_WAIT2		= 2,
		FLUSH_STATE_ARBITER_WAIT	= 3,
		FLUSH_STATE_DONE			= 4
	} flush_state = FLUSH_STATE_IDLE;

	logic	flushing	= 0;

	always_ff @(posedge clk_ram_2x) begin

		flush_done	<= 0;

		case(flush_state)

			//IDLE: wait for flush request to come in
			FLUSH_STATE_IDLE: begin
				if(flush_arbiter_2x) begin
					flush_state	<= FLUSH_STATE_POD_WAIT;
					flushing	<= 1;
				end
			end	//end FLUSH_STATE_IDLE

			//POD WAIT: wait for the pods to flush their per-channel FIFOs into the per-pod FIFO
			FLUSH_STATE_POD_WAIT: begin
				if(la0_flush_complete && la1_flush_complete)
					flush_state	<= FLUSH_STATE_POD_WAIT2;
			end	//end FLUSH_STATE_POD_WAIT

			//POD WAIT 2: wait for the output FIFOs in both pods to empty
			FLUSH_STATE_POD_WAIT2: begin
				if( (la0_ram_data_rd_size == 0) && (la1_ram_data_rd_size == 0) )
					flush_state	<= FLUSH_STATE_ARBITER_WAIT;
			end	//end FLUSH_STATE_POD_WAIT2

			//We're in the write side clock domain, so check for write size to be max.
			FLUSH_STATE_ARBITER_WAIT: begin
				if( (data_fifo_wr_size == DATA_FIFO_DEPTH) && (addr_fifo_wr_size == ADDR_FIFO_DEPTH) ) begin
					flush_state	<= FLUSH_STATE_DONE;

					flushing	<= 0;
					flush_done	<= 1;
				end
			end	//end FLUSH_STATE_ARBITER_WAIT

			//Done, wait for reset
			FLUSH_STATE_DONE: begin

			end	//end FLUSH_STATE_DONE

		endcase

		//Synchronous reset
		if(trig_rst_arbiter_2x)
			flush_state	<= FLUSH_STATE_IDLE;

	end

	////////////////////////////////////////////////////////////////////////////////////////////////////////////////////
	// Pop the FIFOs into the MIG core

	logic	out_phase	 = 0;

	logic	fifos_ready_to_start;
	logic	outputs_ready;
	logic	cmd_addr_fifo_rd_valid	= 0;
	logic	out_phase_adv			= 0;

	always_comb begin

		cmd_addr_fifo_rd_en	= 0;
		data_fifo_rd_en		= 0;
		out_phase_adv		= 0;

		//Check if FIFOs are ready for us to begin (one command and two data words available)
		fifos_ready_to_start	= (!cmd_addr_fifo_empty) && (data_fifo_rd_size >= 2);
		outputs_ready			= app_rdy && app_wdf_rdy;

		//Idle? Pop data+command FIFO if they're ready
		//(but only if we finished processing the previous command)
		if(fifos_ready_to_start && outputs_ready && !cmd_addr_fifo_rd_valid) begin
			cmd_addr_fifo_rd_en		= 1;
			data_fifo_rd_en			= 1;
			out_phase_adv			= 1;
		end

		//Read second half of a word (but only if we're ready to accept the current one)
		if(out_phase && data_fifo_rd_valid && !cmd_addr_fifo_rd_en && app_wdf_rdy)
			data_fifo_rd_en			= 1;

	end

	logic	data_fifo_rd_valid		= 0;
	logic	out_phase_ff			= 0;
	always_ff @(posedge clk_ram) begin

		data_fifo_rd_valid	<= data_fifo_rd_en;
		out_phase			<= out_phase_adv;
		out_phase_ff		<= out_phase;

		//Write FIFO ready? Can process write events
		if(app_wdf_rdy) begin
			app_wdf_wren	<= 0;
			app_wdf_end		<= 0;

			if(data_fifo_rd_valid) begin
				app_wdf_wren	<= 1;
				app_wdf_mask	<= 0;
				app_wdf_data	<= fifo_rd_data;
				app_wdf_end		<= out_phase_ff;	//second half of burst?
			end
		end

		//Write FIFO is not ready! Freeze and don't do anything
		else begin
		end

		//Command FIFO ready? Can process commands
		if(app_rdy) begin

			//Clear single cycle flags
			app_en			<= 0;

			if(cmd_addr_fifo_rd_valid) begin
				app_cmd 				<= {2'b0, fifo_rd_cmd };
				app_addr				<= fifo_rd_addr;
				app_en					<= 1;
				cmd_addr_fifo_rd_valid	<= 0;
			end

		end

		//This has to be at end to take precedence over clearing the valid flag when dispatching a new command
		if(cmd_addr_fifo_rd_en)
			cmd_addr_fifo_rd_valid	<= 1;

	end

	////////////////////////////////////////////////////////////////////////////////////////////////////////////////////
	// Performance counters

	localparam CLK_RAM_HZ = 162500000;

	logic[31:0] count_1hz	= 0;
	logic		pps			= 0;

	logic[31:0]	running_app_cmds		= 0;
	logic[31:0]	running_write_bursts	= 0;
	logic[31:0]	running_write_words		= 0;
	logic[31:0]	running_read_bursts		= 0;
	logic[31:0]	running_read_words		= 0;
	logic[31:0] running_app_unavail		= 0;
	logic[31:0] running_write_unavail	= 0;
	logic[31:0] running_app_unused		= 0;

	logic[31:0]	ops_per_sec				= 0;
	logic[31:0] write_mbps				= 0;
	logic[31:0] read_mbps				= 0;
	logic[31:0]	overhead_mbps			= 0;
	logic[31:0] avail_mbps				= 0;

	always_ff @(posedge clk_ram) begin

		//1 Hz counter
		count_1hz		<= count_1hz + 1;
		pps				<= 0;

		if(count_1hz == (CLK_RAM_HZ - 1) ) begin
			pps			<= 1;
			count_1hz	<= 0;
		end

		//Running counter of events
		if(app_en && app_rdy)
			running_app_cmds		<= running_app_cmds + 1;
		if(app_wdf_wren && app_wdf_rdy)
			running_write_words		<= running_write_words + 1;
		if(app_wdf_wren && app_wdf_rdy && app_wdf_end)
			running_write_bursts	<= running_write_bursts + 1;
		if(!app_rdy)
			running_app_unavail		<= running_app_unavail + 1;
		if(app_rdy && !app_en)
			running_app_unused		<= running_app_unused + 1;
		if(app_rd_data_valid)
			running_read_words		<= running_read_words + 1;
		if(app_rd_data_valid && app_rd_data_end)
			running_read_bursts		<= running_read_bursts + 1;

		//Process the last second's events
		if(pps) begin

			//Calculate values from counters
			//Each word is 256 bits, so 4096 (2^12) words/sec is 1 Mbps
			ops_per_sec				<= running_app_cmds;
			write_mbps				<= running_write_words[31:12];
			read_mbps				<= running_read_words[31:12];
			overhead_mbps			<= running_app_unavail[31:12];
			avail_mbps				<= running_app_unused[31:12];

			//Reset counters
			running_app_cmds		<= 0;
			running_write_words		<= 0;
			running_write_bursts	<= 0;
			running_read_words		<= 0;
			running_read_bursts		<= 0;
			running_app_unavail		<= 0;
			running_write_unavail	<= 0;
			running_app_unused		<= 0;
		end
	end

	////////////////////////////////////////////////////////////////////////////////////////////////////////////////////
	// Debug logic analyzer

	/*
	vio_0 vio(
		.clk(clk_ram),
		.probe_in0(ops_per_sec),
		.probe_in1(write_mbps),
		.probe_in2(overhead_mbps),
		.probe_in3(avail_mbps),
		.probe_in4(read_mbps)
		);

	ila_1 ila(
		.clk(clk_ram_2x),
		.probe0(rr_source),
		.probe1(current_source),
		.probe2(input_data_ready),
		.probe3(addr_fifo_wr_en),
		.probe4(addr_fifo_wr_data),
		.probe5(iaddr_rd_valid),
		.probe6(idata_rd_valid),
		.probe7(rd_phase),
		.probe8(burst_count),
		.probe9(data_fifo_wr_en)
	);
	*/
	/*
	ila_2 ila2(
		.clk(clk_ram),
		.probe0(data_fifo_rd_size),
		.probe1(data_fifo_rd_en),
		.probe2(cmd_addr_fifo_rd_en),
		.probe3(cmd_addr_fifo_rd_size),
		.probe4(cmd_addr_fifo_empty)
		//TODO
	);
	*/

endmodule
