azonenberg/sata-sniffer/(commit log)

2021-11-10 Continued work on schematic. DDR power decoupling, FPGA decoupling, lots more block diagram
    [DDR.sch, expansion.sch, fpgapwr.sch, io_3v3.sch, psu.sch, rgmii.sch, serdes.sch, sniffer.sch]
2021-11-11 Added flash and FPGA support pages, initial DDR pinout, started work on 1G PHY
    [DDR.sch, expansion.sch, flash.sch, fpgapwr.sch, fpgasupport.sch, io_3v3.sch, psu.sch, rgmii.sch]
2021-11-12 More work on schematic including 3.3V I/O, power supply, SERDES lines, etc
    [DDR.sch, expansion.sch, flash.sch, fpgapwr.sch, fpgasupport.sch, io_3v3.sch, psu.sch, rgmii.sch]
2021-11-12 Updated date
    [DDR.sch, expansion.sch, flash.sch, fpgapwr.sch, fpgasupport.sch, io_3v3.sch, psu.sch, rgmii.sch]
2021-11-13 Finished initial schematic, ready for design review
    [DDR.sch, expansion.sch, flash.sch, fpgapwr.sch, fpgasupport.sch, io_3v3.sch, psu.sch, rgmii.sch]
2021-11-17 Finished initial schematic review
    [DDR.sch, expansion.sch, flash.sch, fpgapwr.sch, fpgasupport.sch, io_3v3.sch, psu.sch, rgmii.sch]
2021-11-18 Picked footprints for all components. No actual stackup or layout work done yet.
    [DDR.sch, expansion.sch, flash.sch, fpgapwr.sch, fpgasupport.sch, io_3v3.sch, psu.sch, rgmii.sch]
2021-11-19 Updating with progress from tonight
    [core_df.csv, core_er.csv, expansion.sch, prepreg_df.csv, prepreg_er.csv, sniffer.kicad_pcb, sniffer.sch]
2021-11-30 Began actual layout!
    [DDR.sch, expansion.sch, flash.sch, fpgapwr.sch, fpgasupport.sch, io_3v3.sch, psu.sch, rgmii.sch]
2021-11-30 Continued initial work on layout. BGA fanout and southwest area
    [expansion.sch, sniffer.kicad_pcb]
2021-12-01 Continued routing for tonight. Bunch of low speed stuff in south area of board.
    [expansion.sch, io_3v3.sch, rgmii.sch, serdes.sch, sniffer.kicad_pcb]
2021-12-02 Finished routing of south area of board including low speed SFP+ and LA connections. Started work on Ethernet.
    [DDR.sch, expansion.sch, flash.sch, fpgapwr.sch, fpgasupport.sch, io_3v3.sch, psu.sch, rgmii.sch]
2021-12-03 Finished routing almost everything except DDR.
    [io_3v3.sch, psu.sch, rgmii.sch, sniffer.kicad_pcb]
2021-12-04 Initial skeleton of RAM matching spreadsheet
    [ram-matching.ods]
2021-12-07 Preliminary layout of DQ byte groups 3:0 on DDR3. Not length matched.
    [DDR.sch, expansion.sch, flash.sch, fpgapwr.sch, fpgasupport.sch, io_3v3.sch, psu.sch, ram-matching.ods]
2021-12-07 Finished initial routing of DDR C/A bus
    [DDR.sch, ram-matching.ods, sniffer.kicad_pcb]
2021-12-08 Fully routed DDR. Length matched first three DQ groups.
    [DDR.sch, expansion.sch, flash.sch, fpgapwr.sch, fpgasupport.sch, io_3v3.sch, psu.sch, ram-matching.ods]
2021-12-11 Continued work on layout. Finished length matchnig all DQ byte groups. Still have to do C/A bus.
    [ram-matching.ods, sniffer.kicad_pcb]
2021-12-11 Matched about 2/3 of the C/A bus
    [ram-matching.ods]
2021-12-14 Finished initial layout. Added power planes and some initial test points
    [DDR.sch, ram-matching.ods]
2022-02-01 Continued work on layout. Added via fences, stitching vias, general silkscreen tweaks, etc
    [DDR.sch]
2022-02-13 Added lots of stitching vias and ground cutouts
2022-02-16 Deleted a bunch of simulations that are no longer current, updated some existing sims
2022-02-16 Added stitching vias to SFP+ GTX line layer changes
    [DDR.sch, expansion.sch, flash.sch, fpgapwr.sch, fpgasupport.sch, io_3v3.sch, psu.sch, rgmii.sch]
2022-02-19 Added power rail test point simulation
2022-02-19 Removed solder paste from SMA compression fit ground pads. Moved "12V DC" text to not overlap bare PCB edge
2022-02-19 Moved U1 refdes to not overlap bare PCB edge
2022-02-27 Re-ran trace simulations with updated stackup
2022-02-28 v0.1c layout with new stackup
    [ram-matching.ods]
2022-03-04 Re-ran DRC one last time. Updated export settings so silkscreen is removed from soldermask apertures
2022-04-13 Updated ignore properties for board
2022-04-15 Switched from MMCM to PLL for 400 MHz clock domain to free up a MMCM for other uses that actually need the extra features
2022-04-17 Lots of progress bringing up IP stack subsystem. Failing timing in TX MAC CRC calculation, probably need to pipeline it like we did with RX.
    [ClockGeneration.sv, EthernetSubsystem.sv, ExpansionTransceiver.sv, QuadPLL.sv, RGMIIInterface.sv, SFPInterface.sv, SnifferTop.sv, top.xdc]
2022-04-23 Continued logic analyzer pod work. Now have arbitration between LA channels up to a single memory bus per pod. Doesn't write to DDR yet.
    [CrossClockFifoTest.sv, LogicAnalyzerSubsystem.sv, LogicPodDatapath.sv, SnifferTop.sv, top.xdc]
2022-04-27 Major rework of memory arbiter subsystem
    [LogicAnalyzerSubsystem.sv, LogicPodDatapath.sv, MemoryArbiter.sv, MemorySubsystem.sv, SnifferTop.sv, top.xdc]
2022-04-29 Fixed output data to RAM being set incorrectly
    [MemoryArbiter.sv]
2022-04-30 Minor tweaks to floorplanning constraints for capture logic. Fixed missing BUFIO. Tweaked memory arbitration.
    [LogicPodArbiter.sv, LogicPodClocking.sv, top.xdc]
2022-05-08 RAM performance test spreadsheet
    [ram-performance.ods]
2022-05-17 Initial work on mcu-pmod board
    [mcu-pmod.kicad_pcb, mcu-pmod.kicad_sch]
2022-05-17 Final rev of mcu-pmod
    [mcu-pmod.kicad_pcb]
2022-06-01 v0.2 of mcu-pmod with correct STM32 footprint
    [mcu-pmod.kicad_pcb, mcu-pmod.kicad_sch]
2022-06-10 Fixed pin swap
    [mcu-pmod.kicad_pcb]
2022-06-12 Initial skeleton firmware for mcu-pmod. Just turns on some LEDs, nothing too exciting.
2022-06-12 Added 50 MHz clock output on pmod connector
2022-06-12 Updated stm32-cpp
2022-06-13 Fixed TX/RX swap in schematic
    [mcu-pmod.kicad_pcb, mcu-pmod.kicad_sch]
2022-06-13 Initial firmware now supports basic UART logging and device info
2022-07-18 Read MAC address and serial number from I2C EEPROM
2022-07-26 Continued work on QSPI integration
    [mcu-pmod.kicad_sch]
